imoralesgt/AR_CODEX/Control/ArquitecturaFirmware.jpeg

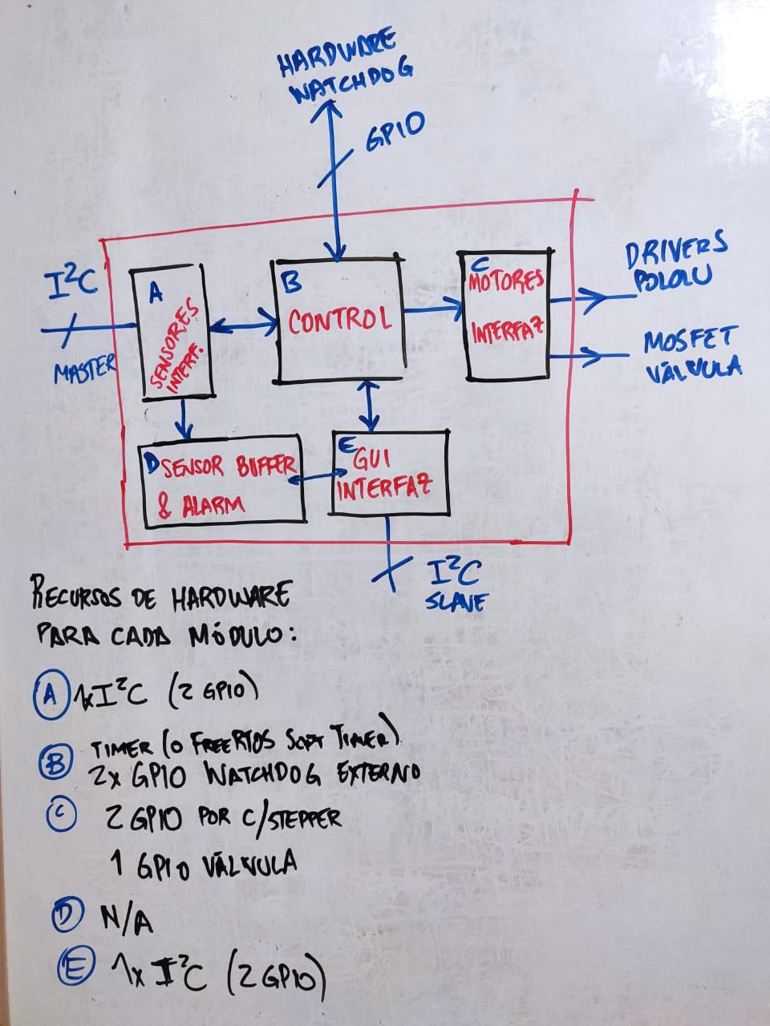
Control/ArquitecturaFirmware.jpeg
