imoralesgt/AR_CODEX/Sensors/Hardware/PCB sensores/Diseño V1/Sensores.png

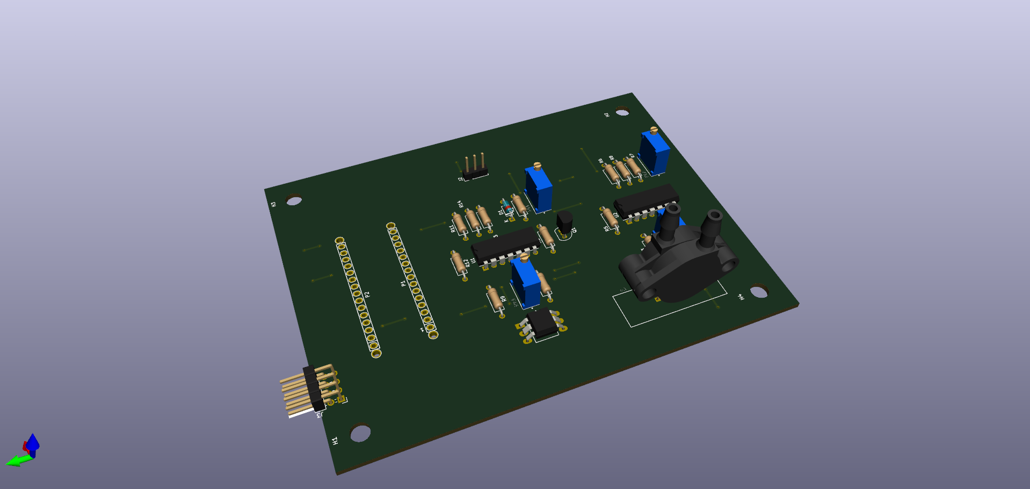
Sensors/Hardware/PCB sensores/Diseño V1/Sensores.png
