imoralesgt/AR_CODEX/Sensors/Hardware/CAD-3D-STL/RedPVC_Manguera.stl

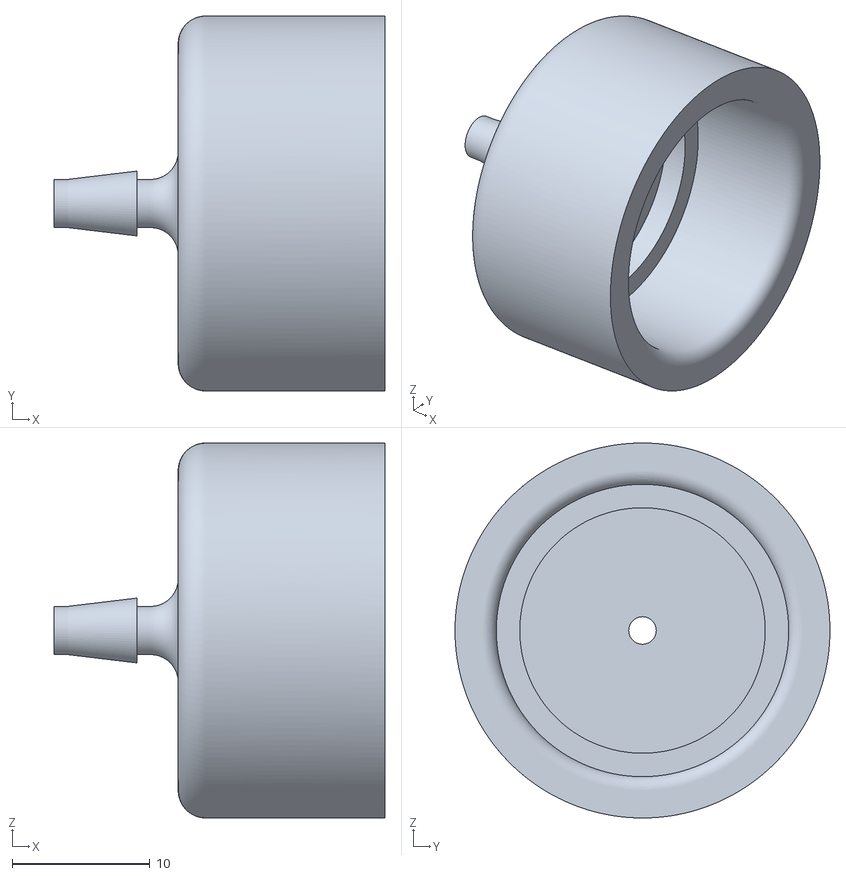
[picture p3: CAD file, 2020-06-14]
Sensors/Hardware/CAD-3D-STL/RedPVC_Manguera.stl
24.0 x 27.2 x 27.2
