imoralesgt/AR_CODEX/Sensors/Hardware/CAD-3D-STL/Sensor de Flujo/SMF3300_CONECTOR_LONG.stl

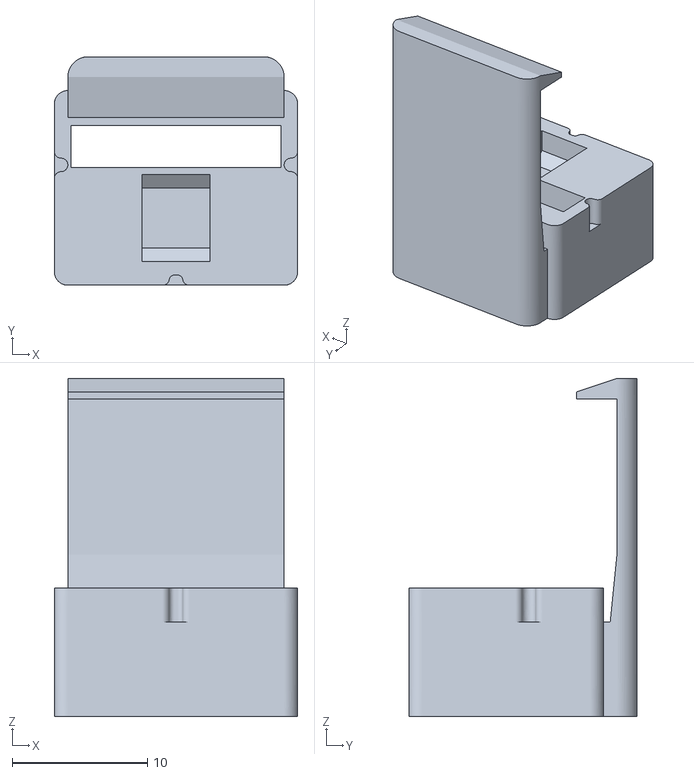
[picture p4: CAD file, 2020-09-03]
Sensors/Hardware/CAD-3D-STL/Sensor de Flujo/SMF3300_CONECTOR_LONG.stl
18.0 x 16.9 x 25.0
