imoralesgt/AR_CODEX/Sensors/Hardware/PCB sensores/MPX/MPX10DP--3DModel-STEP-56544.STEP

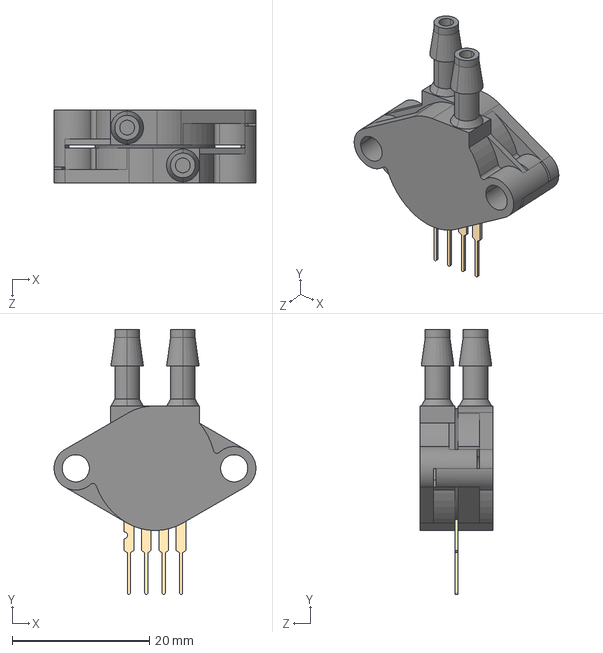
[picture p5: CAD file, 2020-06-14]
Sensors/Hardware/PCB sensores/MPX/MPX10DP--3DModel-STEP-56544.STEP
29.5 x 38.7 x 10.7 mm
