imoralesgt/AR_CODEX/Sensors/Hardware/PCB sensores/Pot/3296W-1-250--3DModel-STEP-56544.STEP

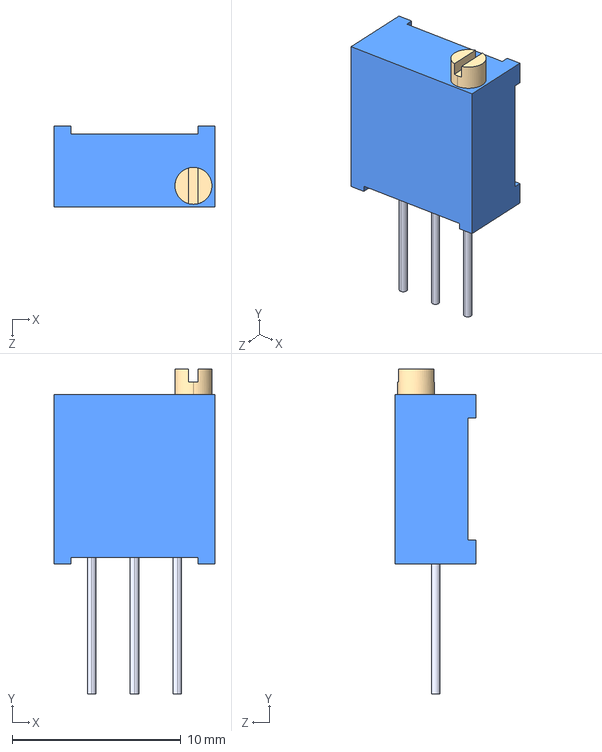
[picture p6: CAD file, 2020-06-14]
Sensors/Hardware/PCB sensores/Pot/3296W-1-250--3DModel-STEP-56544.STEP
9.53 x 19.3 x 4.83 mm
