imoralesgt/AR_CODEX/Sensors/Hardware/CAD-3D-STL/Codo_boquilla.stl

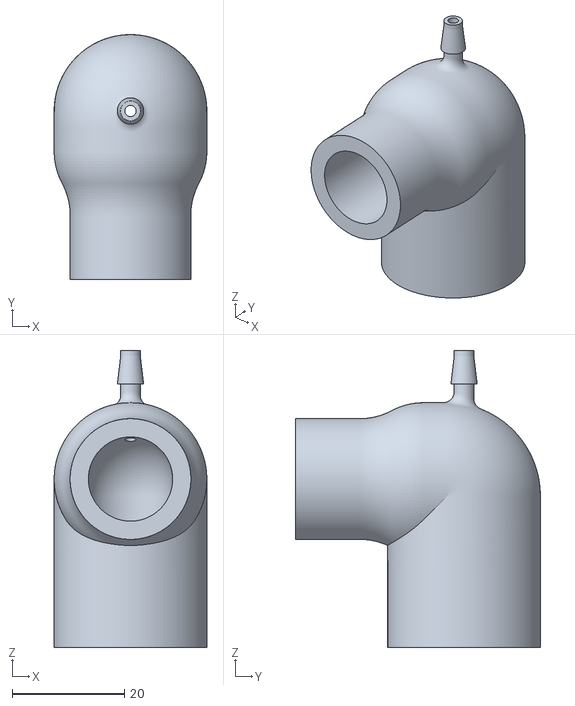
[picture p7: CAD file, 2020-06-14]
Sensors/Hardware/CAD-3D-STL/Codo_boquilla.stl
27.2 x 43.6 x 52.9
