imoralesgt/AR_CODEX/Sensors/Hardware/CAD-3D-STL/Sensor de Flujo/SMF3300_CONECTOR.stl

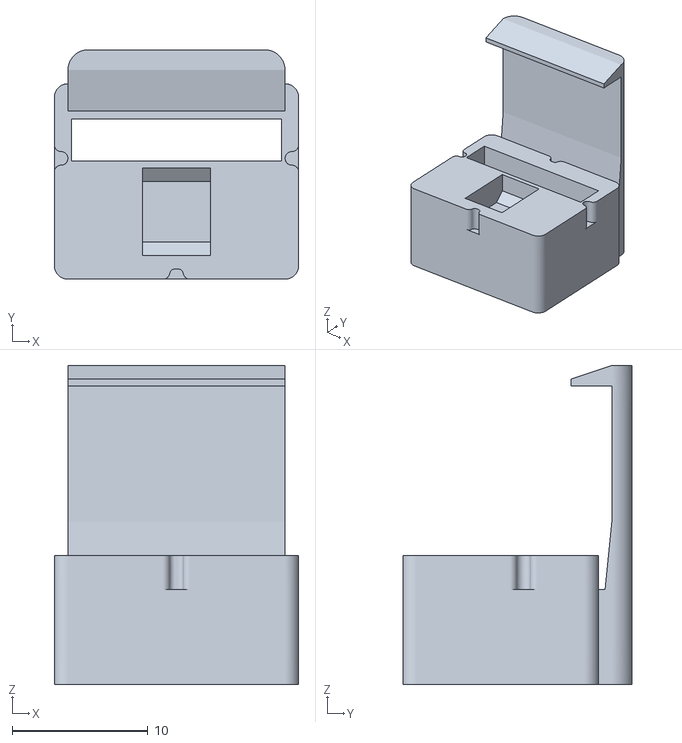
[picture p8: CAD file, 2020-09-03]
Sensors/Hardware/CAD-3D-STL/Sensor de Flujo/SMF3300_CONECTOR.stl
18.0 x 16.9 x 23.5
