imoralesgt/AR_CODEX/Sensors/Hardware/CAD-3D-STL/Sensor de Flujo/Conector.stl

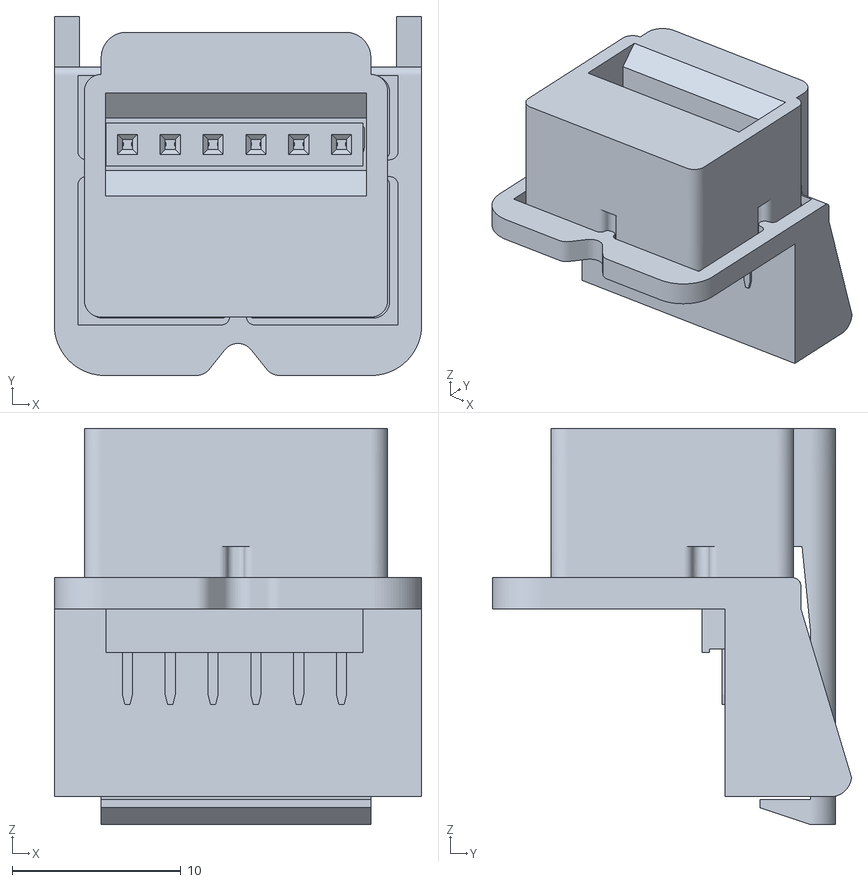
[picture p9: CAD file, 2020-09-03]
Sensors/Hardware/CAD-3D-STL/Sensor de Flujo/Conector.stl
21.8 x 21.3 x 23.5
