imoralesgt/AR_CODEX/Sensors/Hardware/CAD-3D-STL/VenturiV2.stl

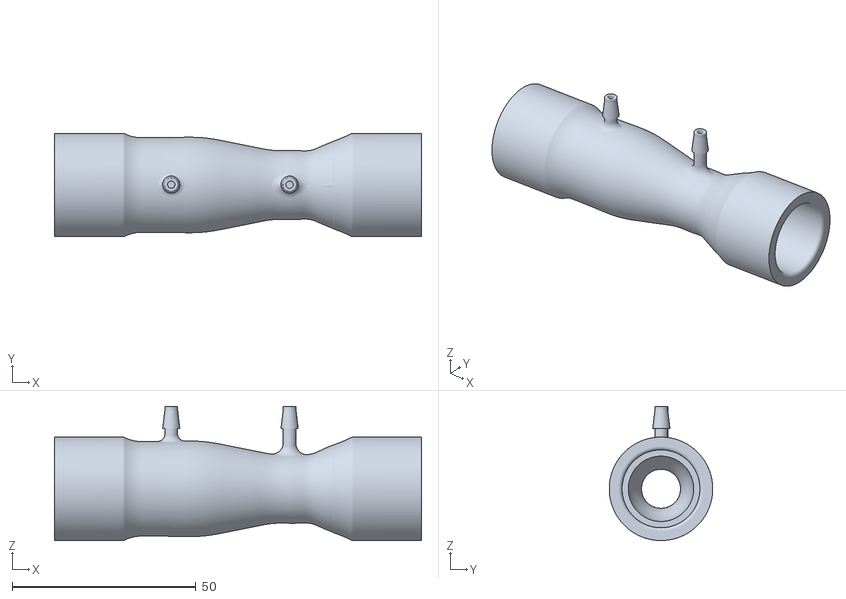
[picture p10: CAD file, 2020-06-14]
Sensors/Hardware/CAD-3D-STL/VenturiV2.stl
100.0 x 28.2 x 36.5
