imoralesgt/AR_CODEX/Sensors/Hardware/CAD-3D-STL/UnionAmbu_PVC.stl

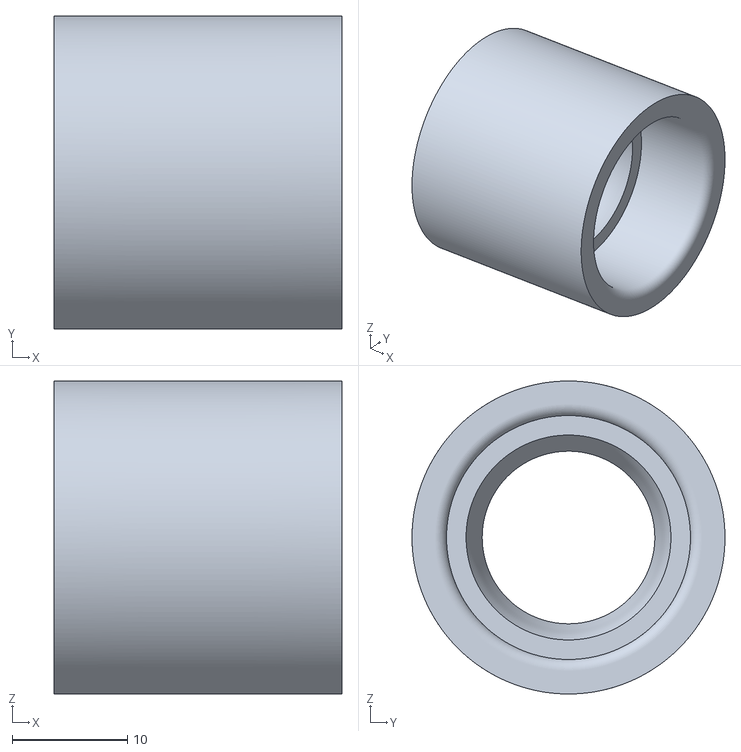
[picture p11: CAD file, 2020-06-14]
Sensors/Hardware/CAD-3D-STL/UnionAmbu_PVC.stl
25.0 x 27.2 x 27.2
