imoralesgt/AR_CODEX/(list of files, cad)

Other CAD files:
3DModels/EndSwitch.ipt
3DModels/OldVersions/EndSwitch.0001.ipt
3DModels/OldVersions/StartAssembly.0002.iam
3DModels/OldVersions/StartSupport.0009.ipt
3DModels/StartAssembly.iam
3DModels/StartSupport.ipt
Sensors/Hardware/CAD-3D-STL/Sensor de Flujo/Conector.iam
Sensors/Hardware/CAD-3D-STL/Sensor de Flujo/OldVersions/Conector.0004.iam
Sensors/Hardware/CAD-3D-STL/Sensor de Flujo/OldVersions/PCB_SMF3300.0005.ipt
Sensors/Hardware/CAD-3D-STL/Sensor de Flujo/OldVersions/SMF3300_CONECTOR.0009.ipt
Sensors/Hardware/CAD-3D-STL/Sensor de Flujo/OldVersions/TUBE_PCB.0008.ipt
Sensors/Hardware/CAD-3D-STL/Sensor de Flujo/PCB_SMF3300.ipt
Sensors/Hardware/CAD-3D-STL/Sensor de Flujo/SMF3300_CONECTOR.ipt
Sensors/Hardware/CAD-3D-STL/Sensor de Flujo/TUBE_PCB.ipt
