imoralesgt/AR_CODEX/PCBControl/PCB-fuente_2step_ATmegaVF3v3/PCB-fuenteback.jpg

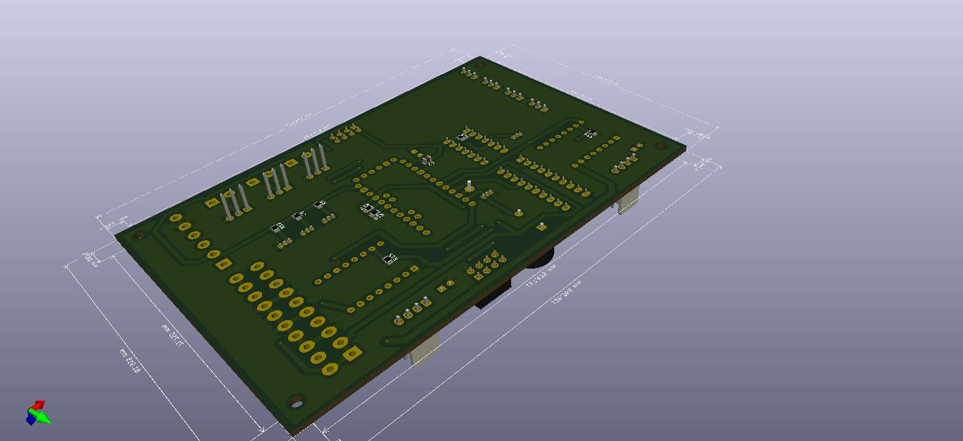
PCBControl/PCB-fuente_2step_ATmegaVF3v3/PCB-fuenteback.jpg
