imoralesgt/AR_CODEX/Sensors/Firmware/Testing/SENSORS/ADP1101/Graficas y Muestras/Lecturas(24cmH2O).png

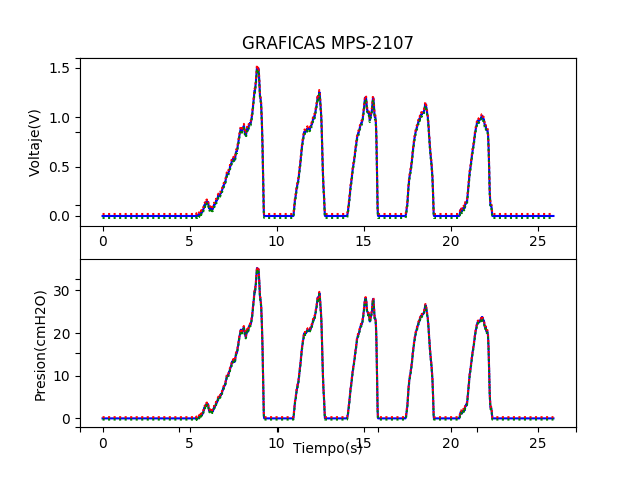
Sensors/Firmware/Testing/SENSORS/ADP1101/Graficas y Muestras/Lecturas(24cmH2O).png
