imoralesgt/AR_CODEX/Sensors/Firmware/Testing/SENSORS/ADP1101/Graficas y Muestras/Lecturas(34cmH2O).png

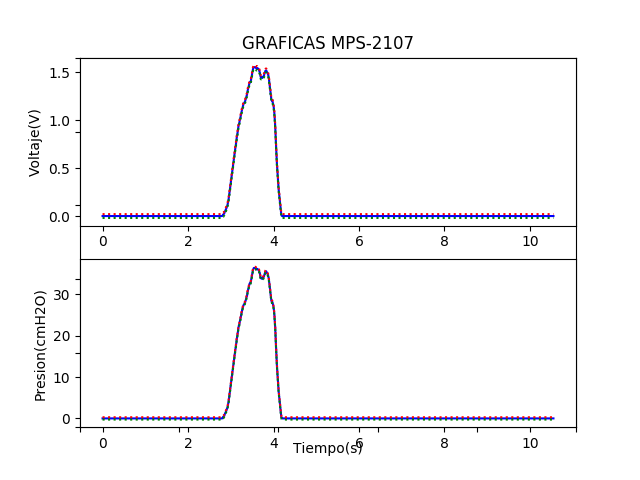
Sensors/Firmware/Testing/SENSORS/ADP1101/Graficas y Muestras/Lecturas(34cmH2O).png
