imoralesgt/AR_CODEX/PCBControl/PCB-fuente_2step_ATmegaVF3v3/esquema.pdf

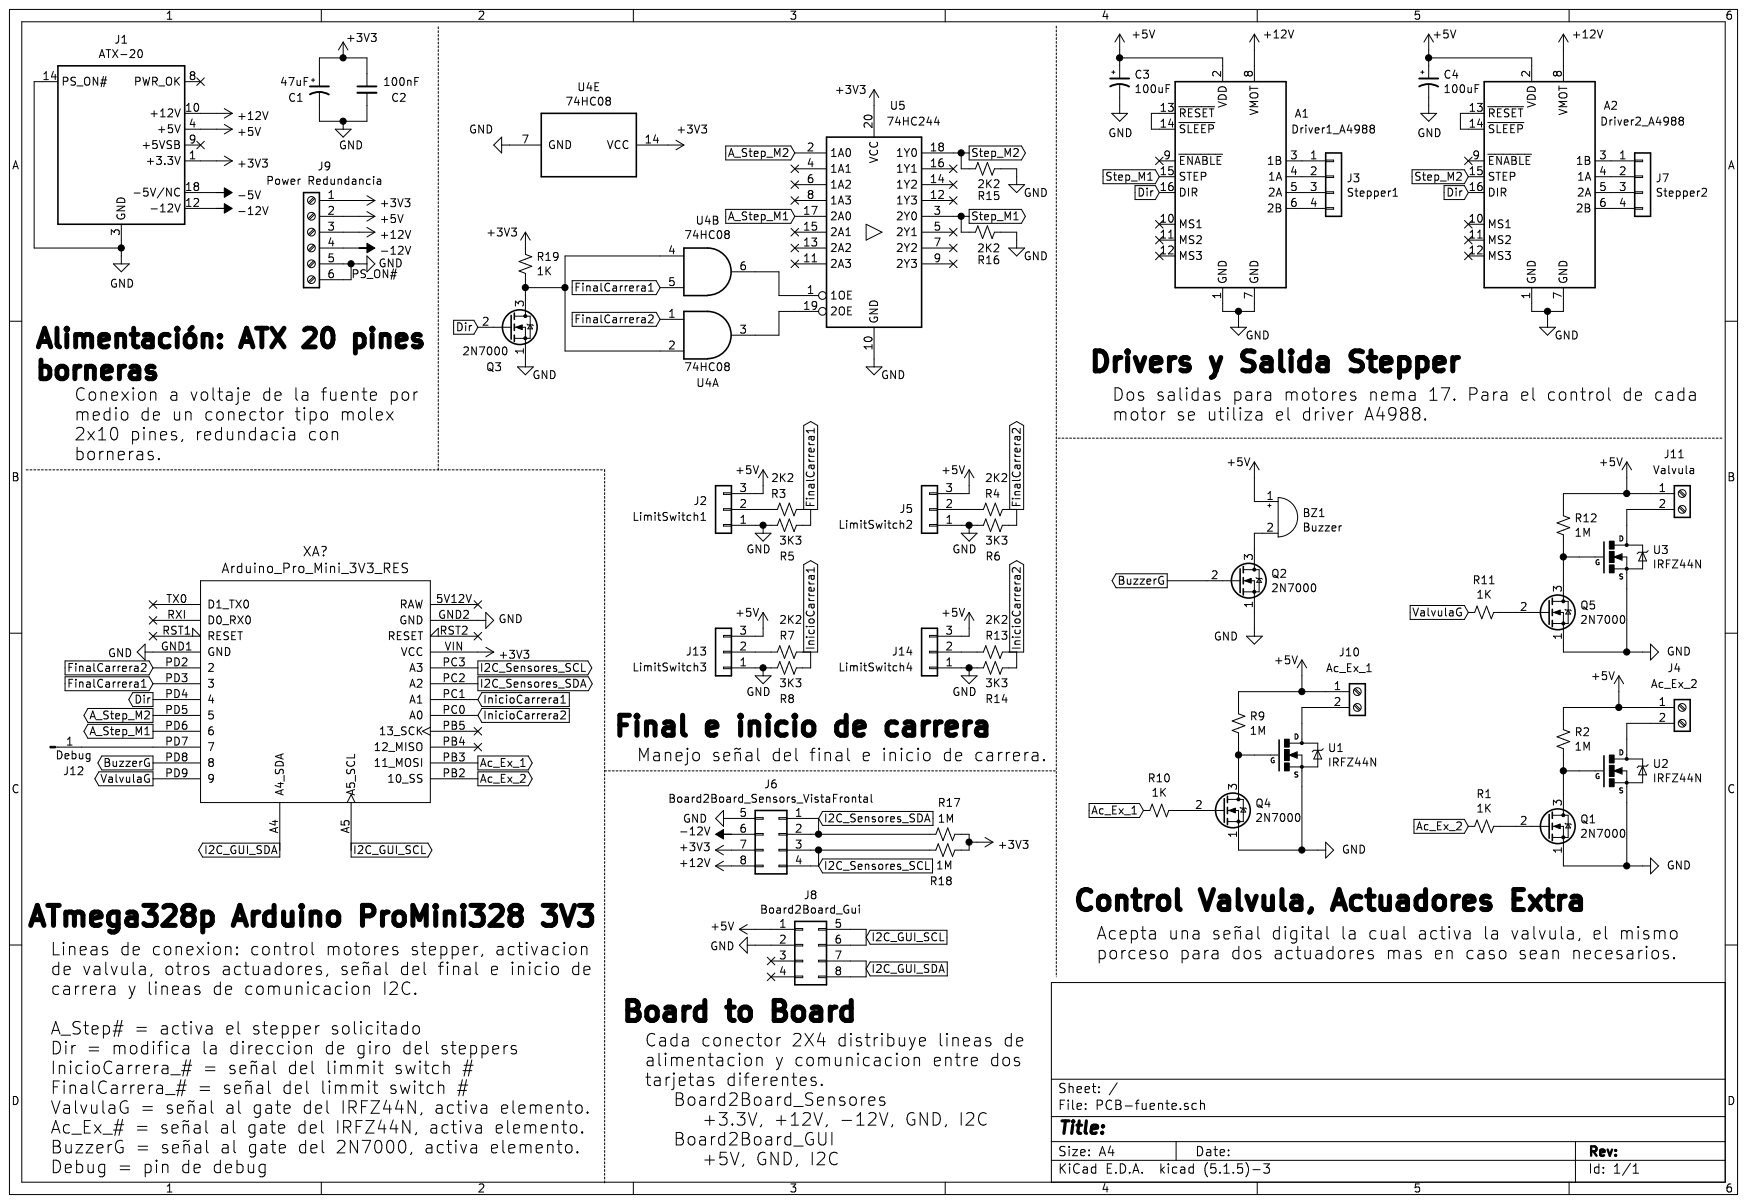
[picture p25: page 1]
