imoralesgt/AR_CODEX/PCBControl/PCB-fuente_2step_ATmegaVF3v3/placa.pdf

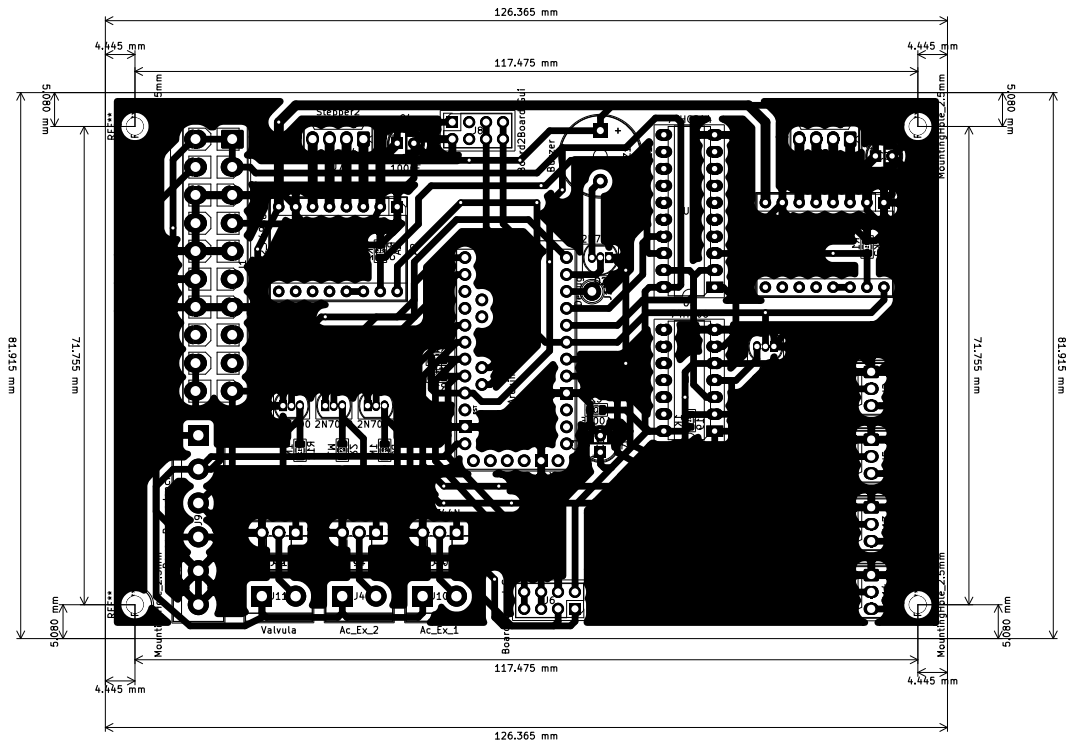
[picture p26: page 1]
