imoralesgt/AR_CODEX/PCBControl/PCB-fuente_2step_ATmegaVF3v3/placa1.pdf

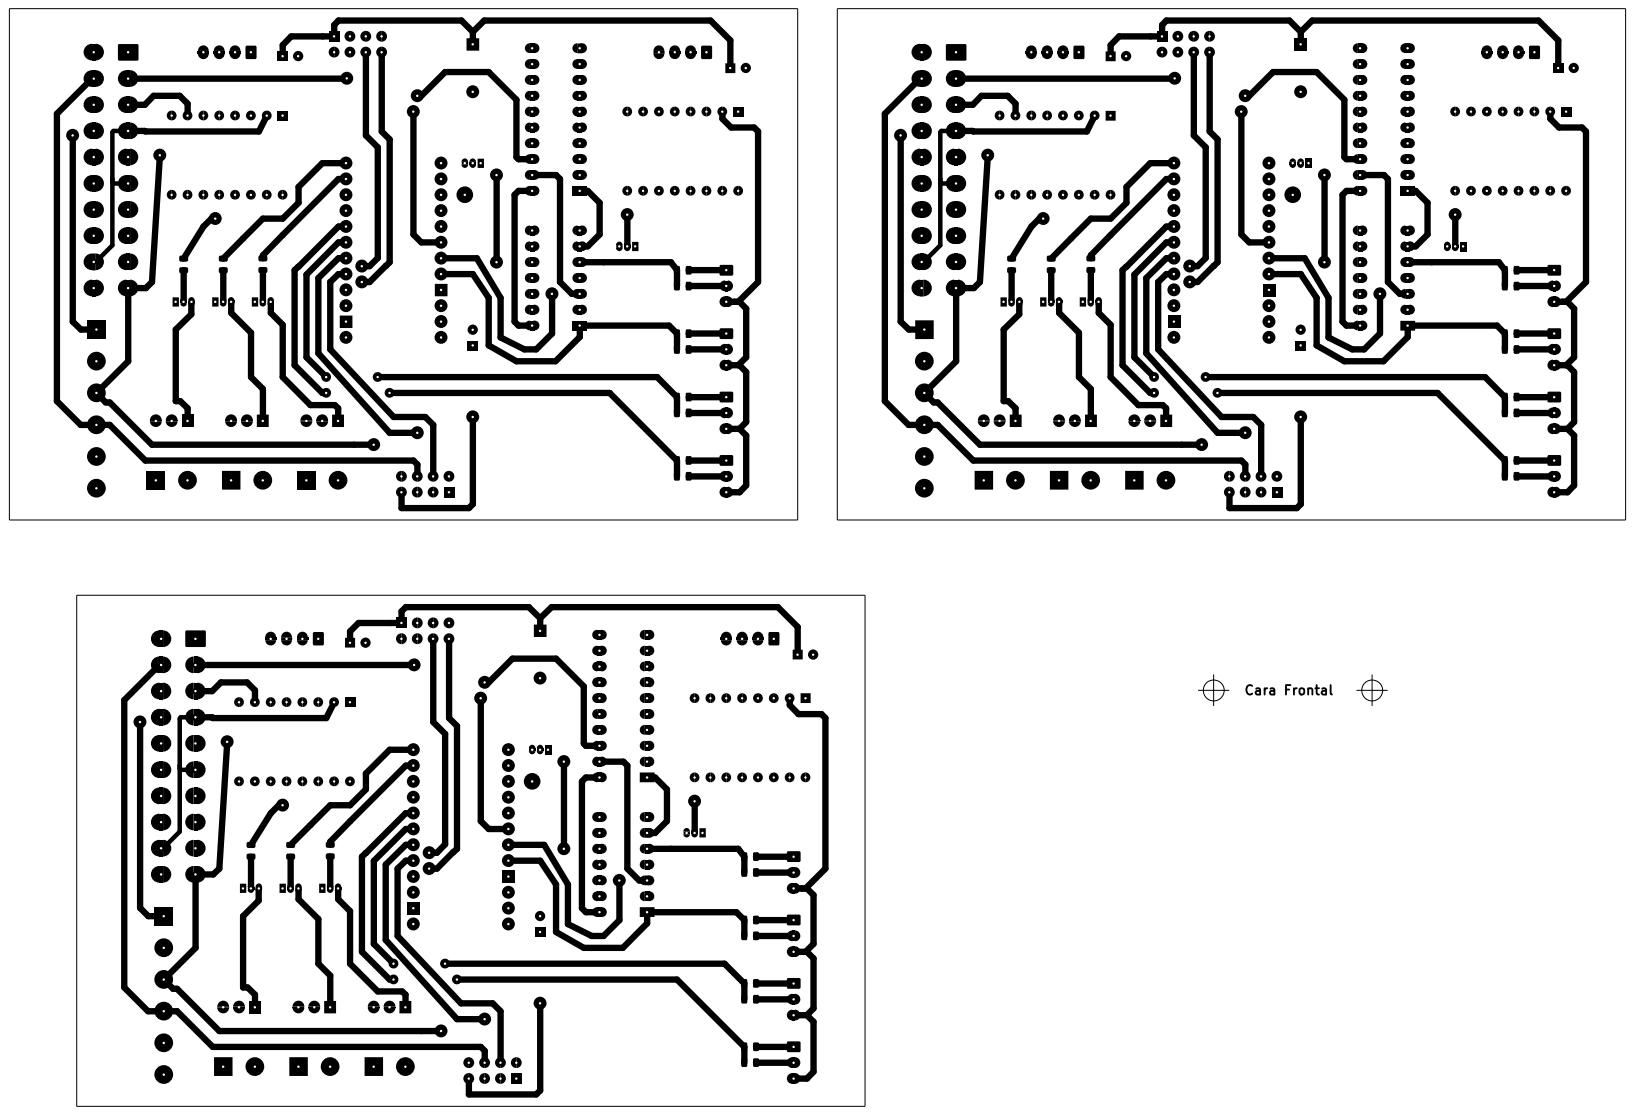
[picture p27: page 1]

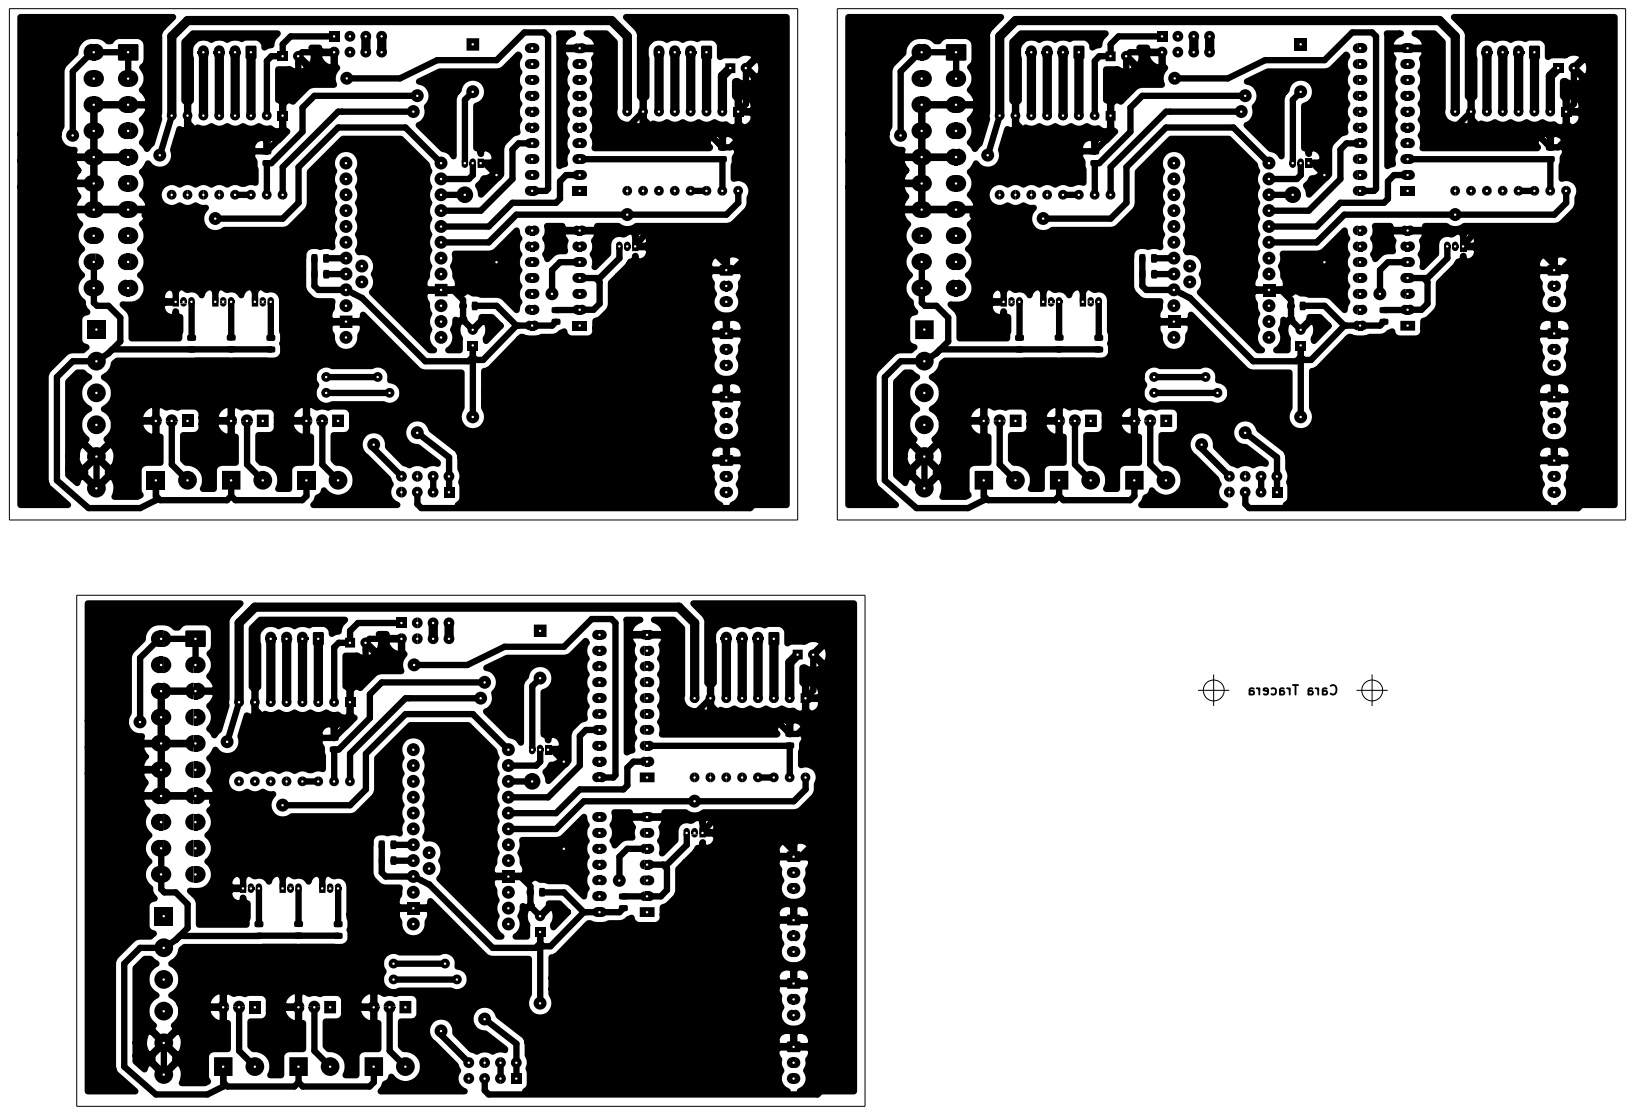
[picture p28: page 2]

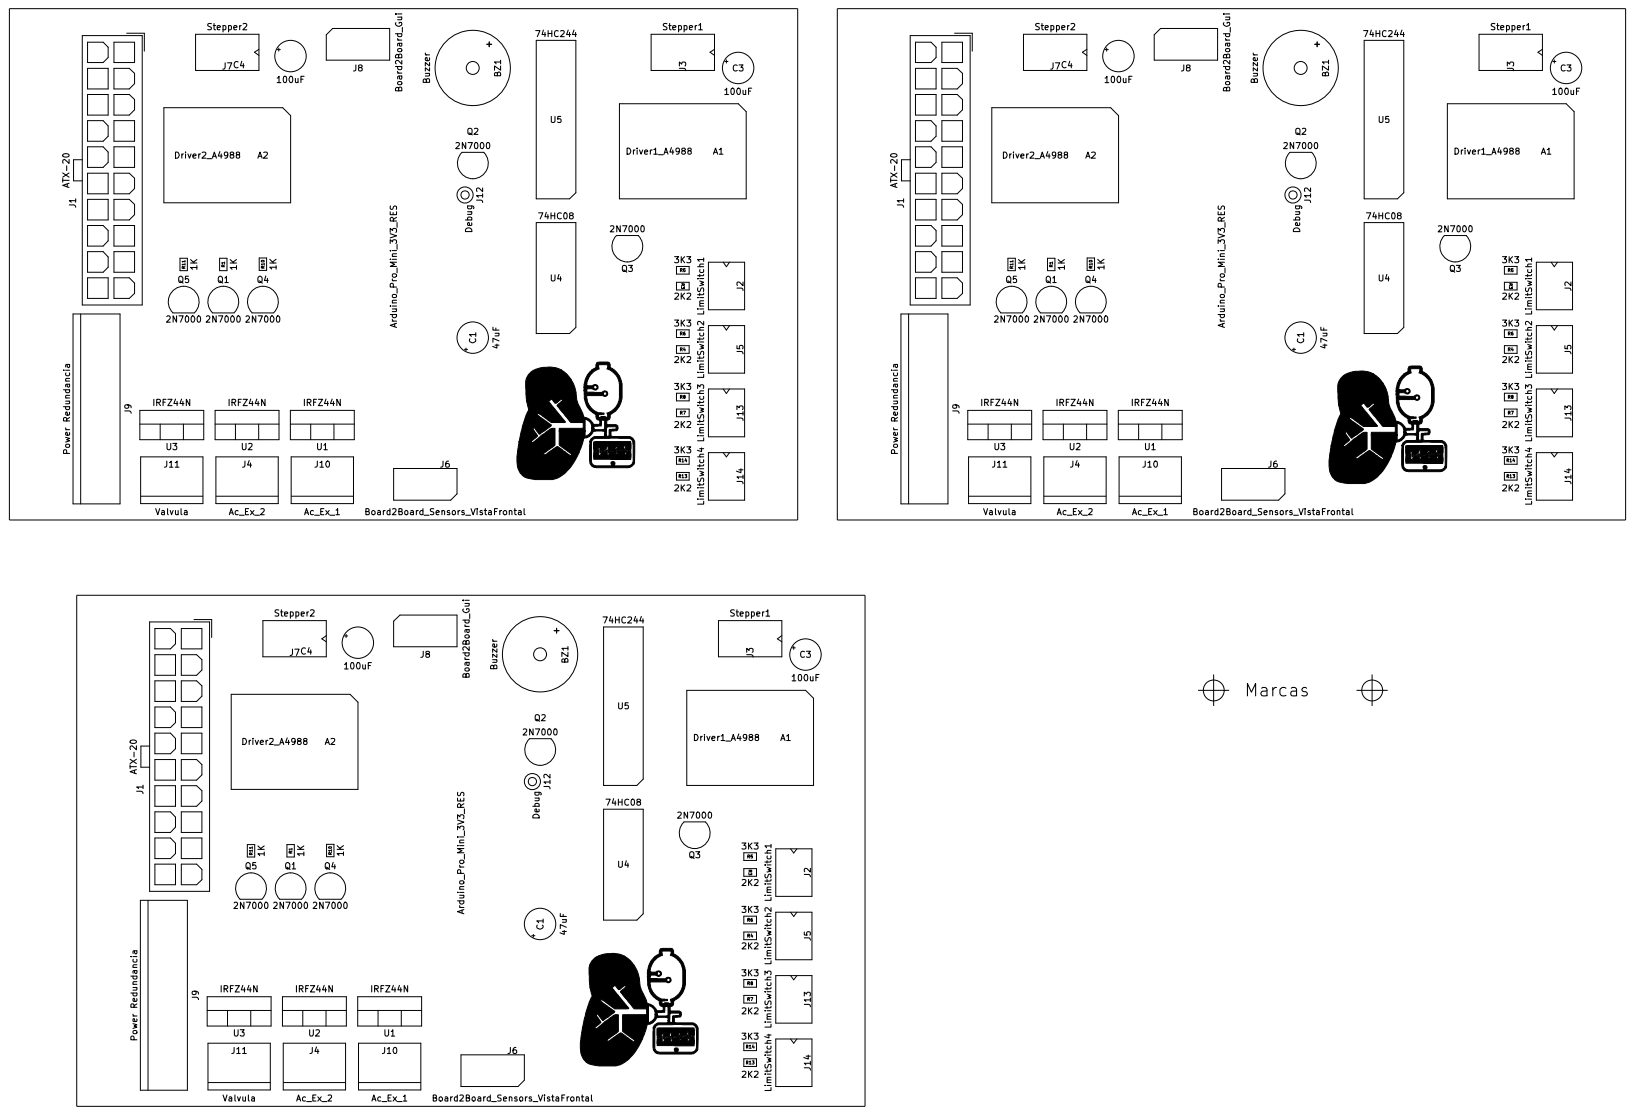
[picture p29: page 3]
