imoralesgt/AR_CODEX/PCBControl/PCB-fuente_2step_ATmegaVF3v3/placa1invert.pdf

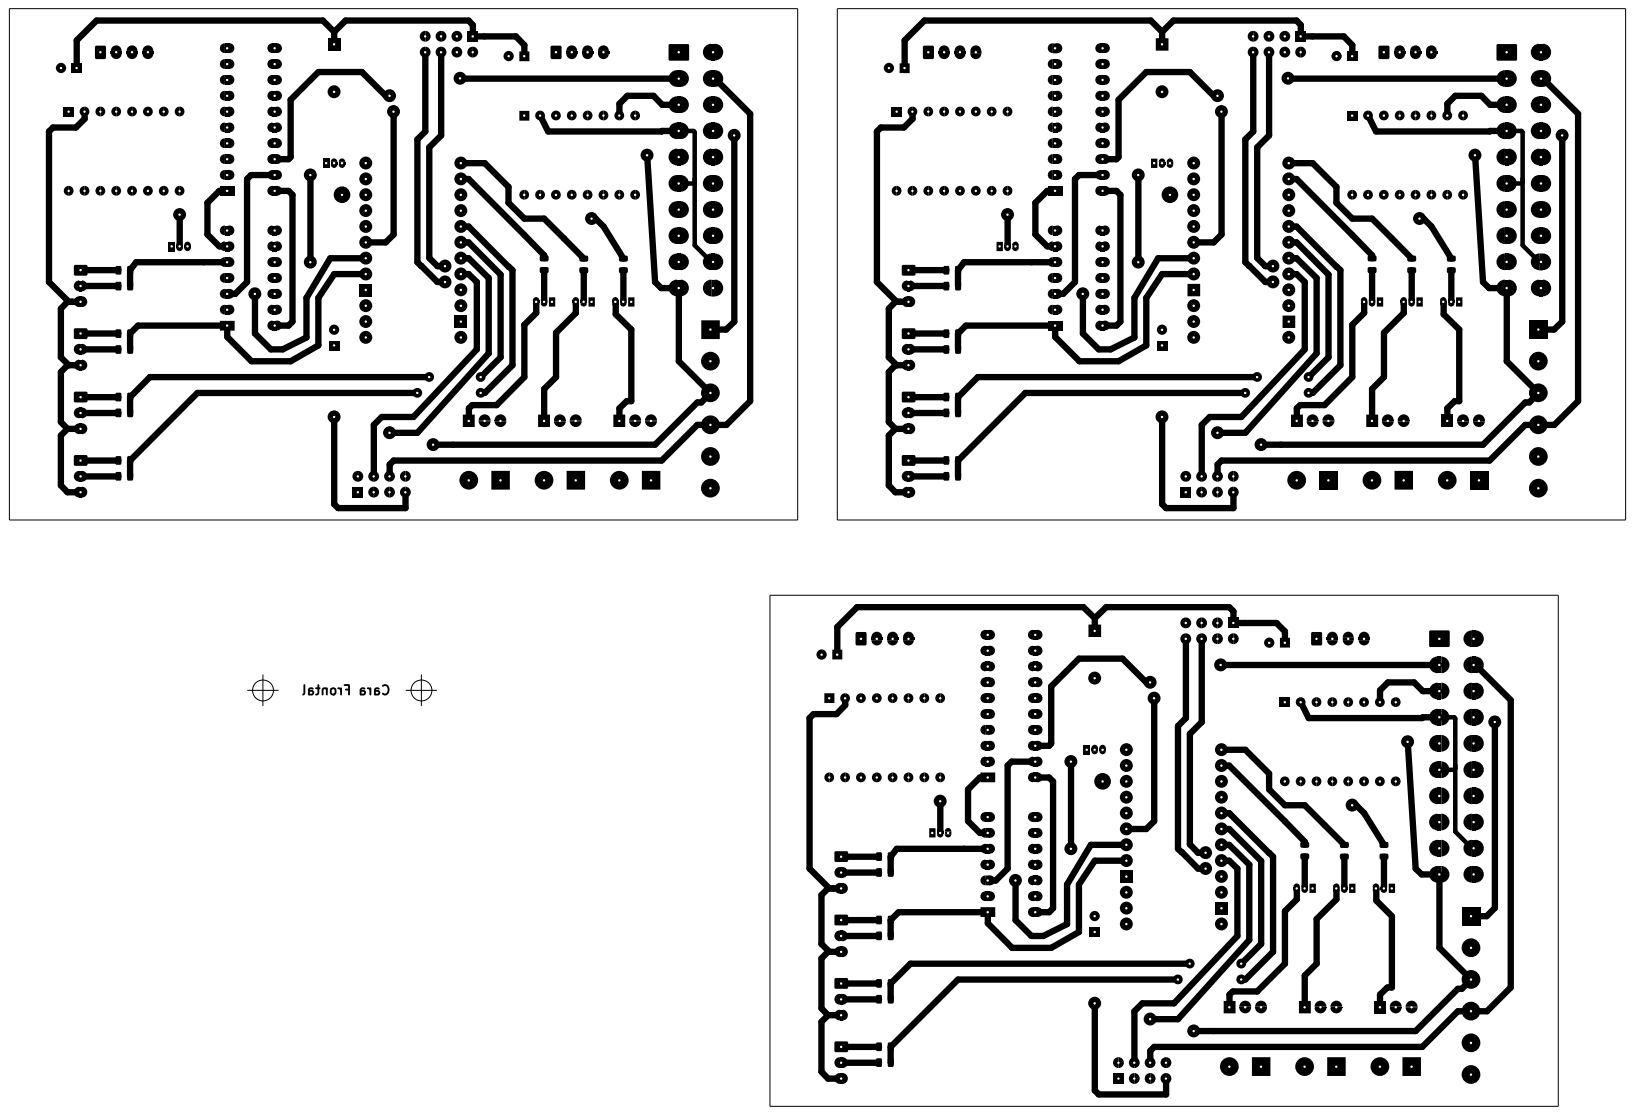
[picture p30: page 1]

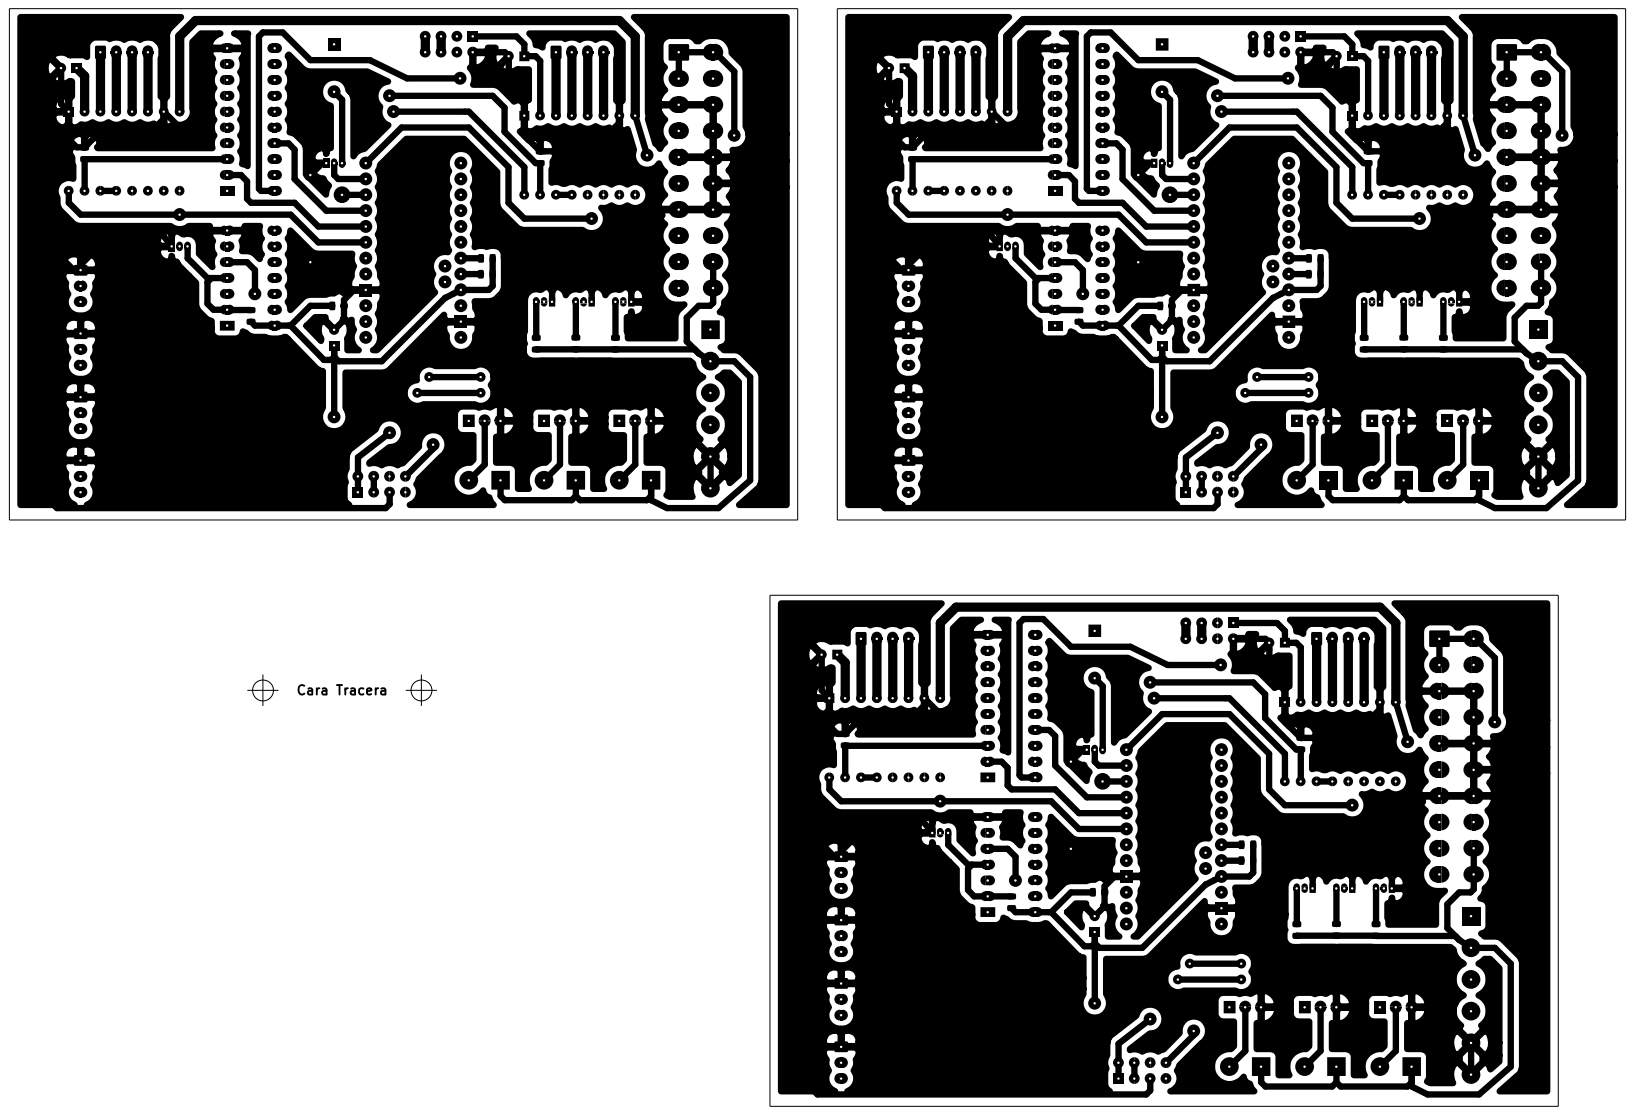
[picture p31: page 2]

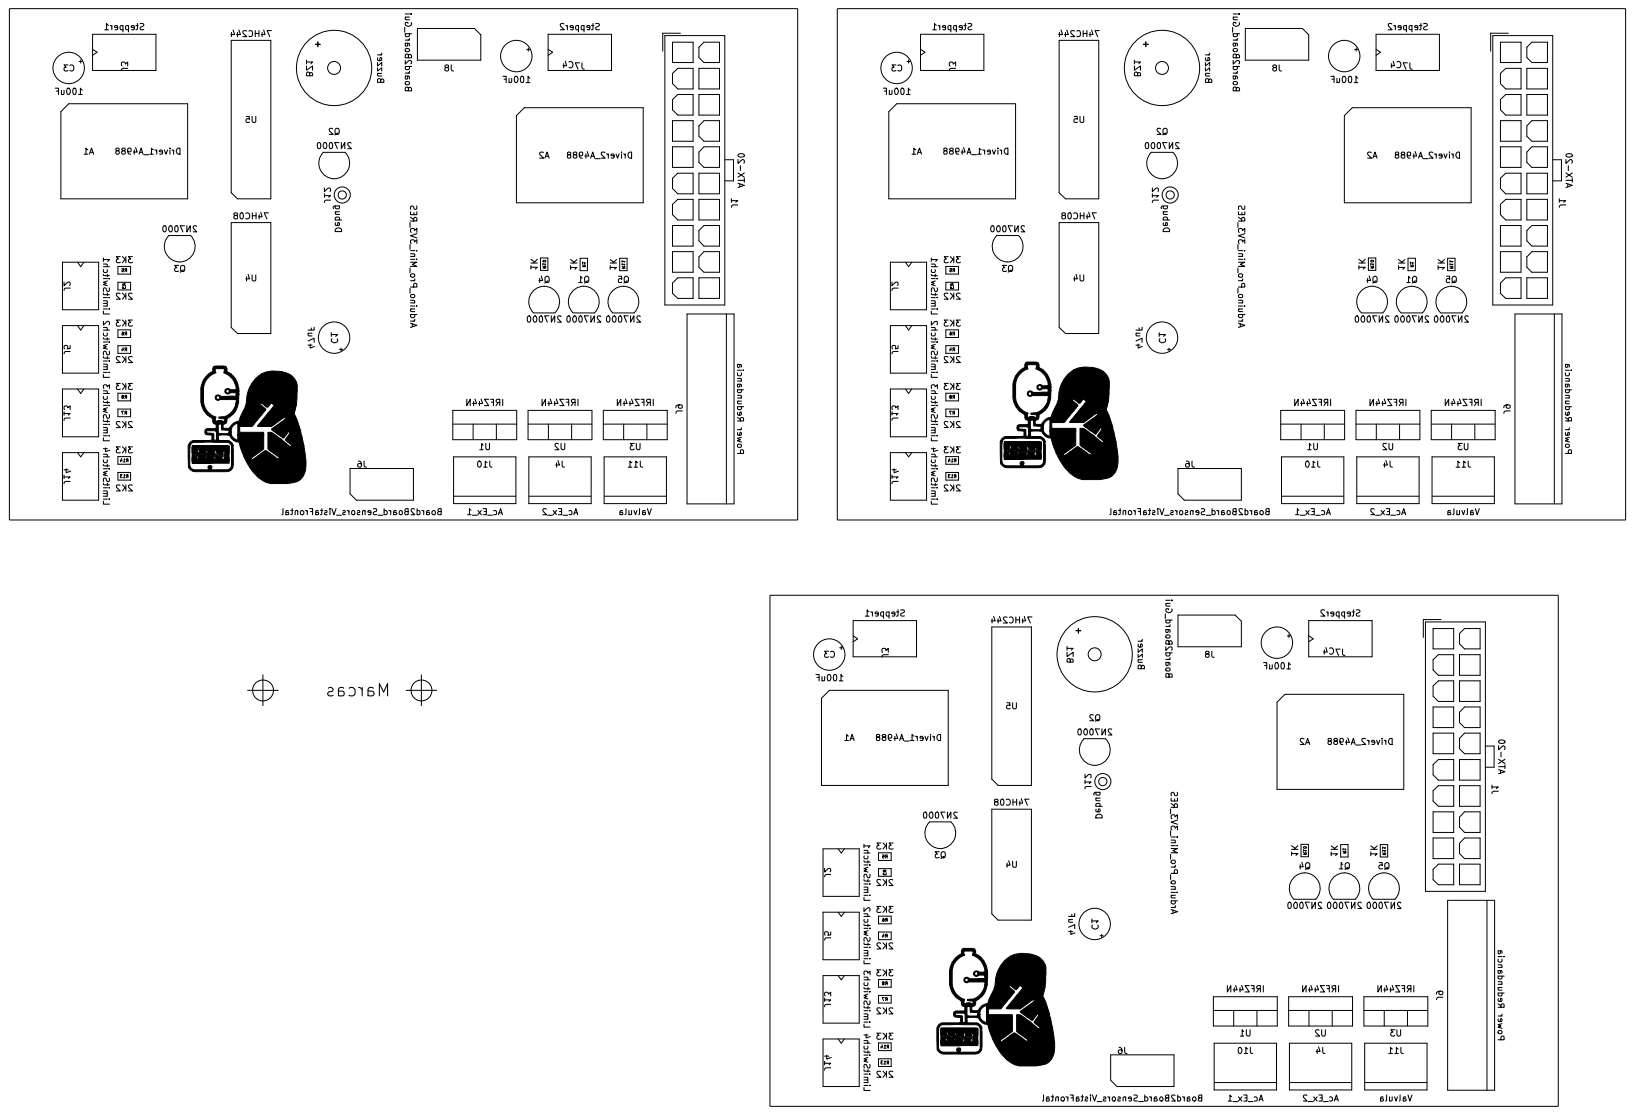
[picture p32: page 3]
