imoralesgt/AR_CODEX/Sensors/Hardware/PCB sensores/Diseño V1/Sensores_V1.kicad_pcb

## KiCad design Sensors/Hardware/PCB sensores/Diseño V1/Sensores_V1.kicad_pcb (2020-06-14)

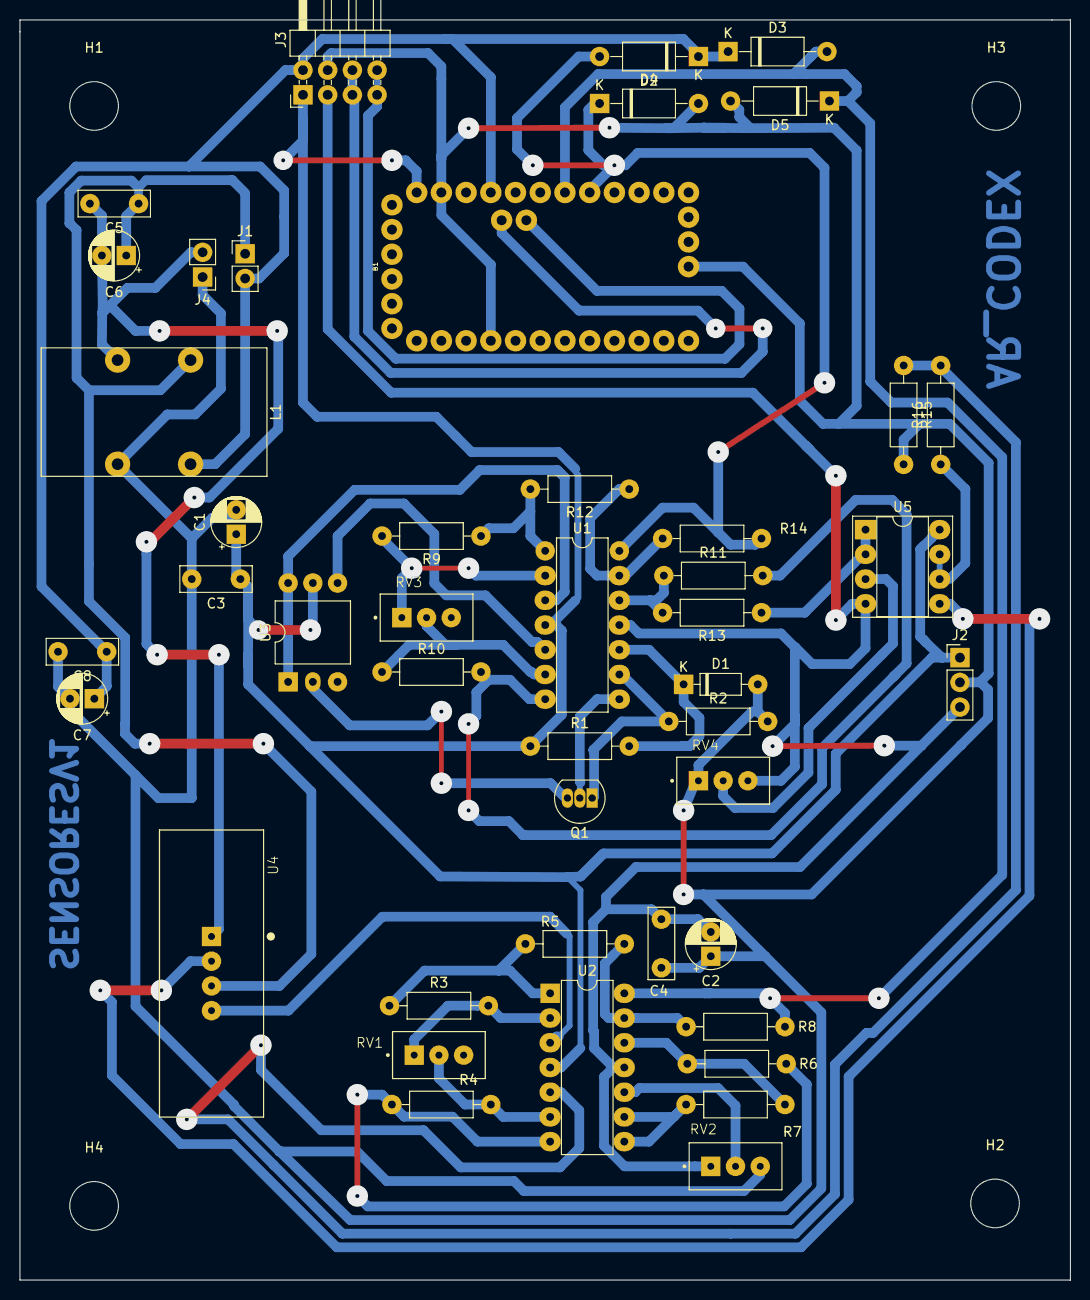
[picture p34: board Sensores_V1.kicad_pcb from above]

Board: 2 copper layers, 108.0 x 129.5 mm, 49 parts (0 on the bottom side), 36 nets.

Parts:
B1: ARDUINO_PRO_MINI
C1, C2, C6, C7: CP; CP_Radial_D5.0mm_P2.50mm
C3, C4, C5, C8: C; C_Rect_L7.2mm_W2.5mm_P5.00mm_FKS2_FKP2_MKS2_MKP2
D1: D_Zener_2.2V; D_DO-35_SOD27_P7.62mm_Horizontal
D2, D3, D4, D5: DIODE; D_A-405_P10.16mm_Horizontal
H1, H2, H3, H4: MountingHole; MountingHole_5mm
J1, J4: Conn_01x02_Female; PinHeader_1x02_P2.54mm_Vertical
J2: Conn_01x03; PinHeader_1x03_P2.54mm_Vertical
J3: Conn_02x04_Top_Bottom; PinHeader_2x04_P2.54mm_Horizontal
L1: L_Core_Ferrite_Coupled; L_CommonMode_Wuerth_WE-CMB-M
Q1: 2N3904; TO-92_Inline
R1: 2k2; R_Axial_DIN0207_L6.3mm_D2.5mm_P10.16mm_Horizontal
R2: 1k5; R_Axial_DIN0207_L6.3mm_D2.5mm_P10.16mm_Horizontal
R3, R4: 100k; R_Axial_DIN0207_L6.3mm_D2.5mm_P10.16mm_Horizontal
R5, R6, R7, R8, R9, R10, R11, R12, R13, R14: 10k; R_Axial_DIN0207_L6.3mm_D2.5mm_P10.16mm_Horizontal
R15: 1M; R_Axial_DIN0207_L6.3mm_D2.5mm_P10.16mm_Horizontal
R16: 5k1; R_Axial_DIN0207_L6.3mm_D2.5mm_P10.16mm_Horizontal
RV1, RV3: 5k; TRIM_3296W-1-254LF
RV2, RV4: 100k; TRIM_3296W-1-254LF
U1, U2: LM324; DIP-14_W7.62mm
U3: ADP1101; DIP-6_W10.16mm
U4: MPX10DP; SIP1067W46P254L2946H2934Q4P
U5: LM358; DIP-8_W7.62mm_Socket

Connections:
+3.3VA: C5.1, C6.1, J1.1, L1.1, U4.3
+3V3: B1.21, C7.1, C8.1, D2.2, D3.2, J1.2, J3.2, L1.2
+12V: B1.24, C1.1, C3.1, J2.1, J3.1, R1.1, U1.4, U2.4, U3.2, U5.8
+OutputADP1101: U1.5, U3.3
+OutputMPX10DP: U4.2, U5.5
-12V: C2.2, C4.2, J2.3, J3.3, RV2.1, RV4.3, U1.11, U2.11, U5.4
-OutputADP1101: U1.3, U3.1, U3.6
-OutputMPX10DP: U2.3, U4.4
/A0:ADP1101: B1.17, D2.1, D4.2, R14.1, U1.14
/A1:MPX10DP: B1.18, D3.1, D5.2, R8.1, U2.14
/I2C:SCL: B1.A5, J3.5, J3.6
/I2C:SDA: B1.A4, J3.7, J3.8
GND: B1.4, B1.23, C1.2, C2.1, C3.2, C4.1, C7.2, C8.2, D1.2, D4.1, D5.1, J2.2, J3.4, J4.1, L1.4, R2.2, R15.2, RV2.3, RV4.1
GNDA: C5.2, C6.2, J4.2, L1.3, U4.1
unnamed: D1.1, R1.2, U1.10
unnamed: Q1.1, R2.1, U1.9
unnamed: Q1.2, U1.8
unnamed: Q1.3, U3.5
unnamed: R3.1, R5.2, U2.1
unnamed: R3.2, RV1.1, U2.2
unnamed: R4.1, RV1.2, U2.6
unnamed: R4.2, R6.2, U2.7
unnamed: R5.1, R8.2, U2.13
unnamed: R6.1, R7.1, U2.12
unnamed: R7.2, U2.8, U2.9
unnamed: R9.2, RV3.1, U1.2
unnamed: R10.1, RV3.2, U1.6
unnamed: R10.2, R11.2, U1.7
unnamed: R11.1, R13.2, U1.12
unnamed: R12.1, R14.2, U1.13
unnamed: R9.1, R12.2, U1.1
unnamed: R13.1, U5.1, U5.2
unnamed: R15.1, R16.2, U2.5
unnamed: R16.1, U5.6, U5.7
unnamed: RV2.2, U2.10
unnamed: RV4.2, U5.3
