imoralesgt/AR_CODEX/Control/arcontrol.cpp

#include "arcontrol.h"
#include "pinout.h"
#include "globals.h"
#include "Pid.h"
#include "pinout.h"
#include "argpio.h"



/*
==========================================================================================================
- Inspiration and expiration slope computation methods done
- Initialization (at constructor) of PID & Motor variables done
- Preliminar version of control strategy done (controlFlow method)

ToDo:
    - Create interconnection methods for external modules
    - Instantiate modules into top module (Control.ino)
    - Interconnect modules into top module (Control.ino)
    - Test control system
==========================================================================================================
*/






//PID Instantiation
Pid pp(KP, KI, KD, MOTOR_MIN_OUT, MOTOR_MAX_OUT);

//GPIO Instantiation
argpio gp;

/*
======================
Constructor/Destructor
======================
*/

arcontrol::arcontrol(){
    this -> __resetInitParametersFlag(); //IRM initialization from GUI not done yet.
    this -> controlSetPoint = 0.0; //IRM Airflow set-point value
}

//IRM Destructor: do nothing
arcontrol::~arcontrol(){
    ;
}




/*
==============
Public methods
==============
*/

//IRM Gets init parameters from GUI I2C controller block, which are set as working set-points.
//Returns 0 if everything ok. Call this method from an external module function
int arcontrol::setInitParameters(float pressure, float minVol, float maxVol, float rpm, float ieRatio){
    this -> __setSpPressure(pressure);
    this -> __setSpRPM(rpm);
    this -> __setSpIeRatio(ieRatio);

    this -> __setSpMinVol(minVol);
    this -> __setSpMaxVol(maxVol);

    this -> __setInitParametersFlag(); //Initial parameters already received!


    //Setup initial motor & PID conditions
    this -> currentCycleSlope = __computeISlope(this->getSpRPM(), this->getSpIeRatio(), this->getSpMinVol(), this->getSpMaxVol());
    this->setCurrentCycleVolume(0); //No air hasn't been pushed yet
    this -> updateSetPoint(this->currentCycleSlope);
    this->currentDirection = INSP;
    pp.resetIDvalues(); 

    this -> inspirationClkCycles = 0;

    
    return 0;
}

void arcontrol::updateControlParameters(float pressure, float minVol, float maxVol, float rpm, float ieRatio){
    this -> __setSpPressure(pressure);
    this -> __setSpRPM(rpm);
    this -> __setSpIeRatio(ieRatio);

    this -> __setSpMinVol(minVol);
    this -> __setSpMaxVol(maxVol);
    pp.resetIDvalues();
}

void arcontrol::updateSetPoint(float sp){
    pp.pidSetPoint(sp);
}

int arcontrol::towardsHome(int motorIndex){
    if(gp.dRead(START_ENDSTOP[motorIndex])){ //if home endstop has been activated
        this -> setMotorSpeed(motorIndex, 0); //Stop motor motion
        //Serial.println("HME");
        return 1; //We have reached home right now!
    }else{
        this -> setMotorSpeed(motorIndex, MOTOR_MIN_OUT);  //Move motor backwards
        //Serial.println("TWDS");
        return 0; //We haven't reached home in the specified motor yet
    }
}


void arcontrol::goHome(void){
    int i;
    int ok = 0;
    this -> motorsHoming = 1;
    while(ok < TOTAL_MOTORS){
        ok = 0;
        for(i = 0; i < TOTAL_MOTORS; i++){
            ok += towardsHome(i);
        }
    }
    this -> motorsHoming = 0;
    this -> motorsHomed = 1;
}


/*
    Estrategia de control:

    Ciclo inicial:
    - Asegurarse que ambú esté presionado 0%
    - Mover motor (lentamente) hasta alcanzar volumen mínimo deseado (tomando como base medidas de flujo/caudal (R))
        ~ Volumen = Caudal * Tiempo
    - Iniciar proceso cíclico contorlado por PID, supervisando no exceder el límite de presión en ningún instante

    Proceso cíclico:
    Calcular el caudal necesario para lograr enviar al paciente el volumen requerido a la tasa de respiraciones
    por minuto, cumpliendo también con la tasa de inspiración y expiración.

    La variable a controlar es el flujo. Las pendientes (Delta V / Delta t) se calculan en base a los siguientes requisitos:
        - Respiraciones por minuto
        - Relación I:E
        - Delta Volumen (Volumen Mínimo Ambu, Volumen Máximo Ambú)

*/


float arcontrol::controlFlow(float currentFlow, float currentPressure){
    volatile float newOutput; //Current output
    static float accumulatedCycleVolume;
    static long accumulatedOverPressureCycles;
    float expirationPeriod;
    static long maxExpirationCycles;
    static long maxInspirationCycles = 0;
    
    static int homedMotors;
    int i;

    if(this->currentDirection == INSP){ //If pushing air into patient's lungs

       
        //Compute current cycle accumulated volume
        accumulatedCycleVolume = this->computeCurrentCycleVolume(currentFlow);
        this -> setCurrentCycleVolume(accumulatedCycleVolume);

        //If inspiration is taking longer than expected, maybe due to a motor stuck in the emergency endstop switch, go back to expiration mode
        this -> inspirationClkCycles += 1;
        #ifdef DEBUG_MODE
            Serial.println(this -> inspirationClkCycles);
        #endif
        if(this -> inspirationClkCycles > maxInspirationCycles){
            this -> inspirationClkCycles = 0;
            accumulatedCycleVolume = this -> getSpMaxVol() + 1;
            setCurrentCycleVolume(accumulatedCycleVolume); //Forcing state change to expiration mode
        }



        //If an overpressure condition is detected
        if(currentPressure > this->getSpPressure()){ //If max. expected pressure is detected
            if(++accumulatedOverPressureCycles < MAX_OVERPRESSURE_CYCLES){
                this->__reduceMaxPIDOut(pp.getMaxOut()); //Gradually reduce motor output speed (inspiration only)
            }else{
                accumulatedOverPressureCycles = 0;
                this -> setCurrentCycleVolume(this->getSpMaxVol() + 1);
            }
        }

        // Serial.print("Vol: "); Serial.println(accumulatedCycleVolume); //Serial.print("Max: "); Serial.println(this -> getSpMaxVol());

        //If maxvol hasn't been reached yet, keep pushing ambu
        if(accumulatedCycleVolume < this->getSpMaxVol()){
            
            newOutput = pp.pidUpdate(currentFlow);

        }else{
            Serial.print("IN ");
            Serial.println(this -> getCurrentCycleVolume());

            Serial.print("MAX ");
            Serial.println(this -> getSpMaxVol());

            //Otherwise, stop motor and change currentDirection to EXPIRATION
            this->setCurrentCycleVolume(this->getSpMaxVol()); //Now start decreasing volume next clock cycle
            expirationPeriod = this -> __computeEDuration(this -> getSpRPM(), this -> getSpIeRatio()); //Expiration (open loop) period
            Serial.print("EXP PER: "); Serial.println(expirationPeriod);
            this -> inspirationClkCycles = 0; //Reset inspiration clock cycles counter
            this -> expirationClkCycles = 0; //Reset expiration clock cycles counter
            this->currentDirection = EXPI;
            homedMotors = 0; //Motors are not located in home position
            pp.setNewMaxOutput(MOTOR_MAX_OUT); //Reset max motor speed to default value 
            pp.resetIDvalues(); //Reset PID accumulated values

            maxExpirationCycles = (long)(expirationPeriod/(float)DT);

            //Serial.print("MXEXPCYC: "); Serial.println(maxExpirationCycles);

            
            newOutput = 0; //Momentaneusly pause motor to start direction reversion
        }

    }else if(this->currentDirection == EXPI){ //If current direction is expiration (pulling ambu out)

        //Serial.println("OUT ");

        newOutput = MOTOR_MIN_OUT;

        //Go to home until limit switches are activated (and keep counting elapsed time)
        //Wait until expiration time has been reached
        this -> expirationClkCycles += 1;

        #ifdef DEBUG_MODE
            Serial.print(" CLKEXP: "); Serial.println(this -> expirationClkCycles);
        #endif
        //Serial.print(" MAXXPRCY: "); Serial.println(maxExpirationCycles);

        if((this -> expirationClkCycles) < maxExpirationCycles){ //Has expiration time passed by?
            //If home hasn't been reached, keep moving motors to initial position
            if(homedMotors < TOTAL_MOTORS){
                for(i = 0; i < TOTAL_MOTORS; i++){
                    homedMotors += towardsHome(i); //Be sure each motor is moved towards home position
                    this -> setMotorSpeed(i, MOTOR_MIN_OUT);
                }
                //Serial.println("TWRDS");
            }else{ //Else, just wait until expiration time has been reached
                for(i = 0; i < TOTAL_MOTORS; i++){
                    this -> setMotorSpeed(i, 0);//Be sure motors are stopped at this point
                }
                //Serial.println("HOMED");
            }

        }else{ //If expiration cycle time has been reached, switch back to inspiration again

            Serial.println("HOMED EXP");

            //Compute inspiration expected cycles, in case pressure and flow stop working, due to a stuck motor at the end (STOP END Activated)
            maxInspirationCycles = (long)((this -> __computeIDuration(this->getSpRPM(), this->getSpIeRatio())/DT) * MAX_INSPIRATION_CYCLES_OVERLOAD_RATIO);

            #ifdef DEBUG_MODE
                Serial.print("MAX_INS_CYC: "); Serial.println(maxInspirationCycles);
            #endif 

            this -> inspirationClkCycles = 0;

            this->currentCycleSlope = this -> __computeISlope(this->getSpRPM(), this->getSpIeRatio(), this->getSpMinVol(), this->getSpMaxVol());
            this->setCurrentCycleVolume(0.0); //Now strat increasing volume again on next cycle
            accumulatedCycleVolume = 0;
            this->currentDirection = INSP;
            this -> updateSetPoint(this->currentCycleSlope);
            pp.resetIDvalues(); //Reset prior accumulated PID values
            newOutput = 0; //Momentaneusly pause motor to start direction reversion

            accumulatedOverPressureCycles = 0; 
        }     

        

    }else{ //No other states have been planned. If entering an invalid state, just shut motors off.
        pp.setNewMaxOutput(0);
        pp.setNewMinOutput(0);
        Serial.println("ERROR STATE");
        return 0; //Motors must be stopped
    } 

    return newOutput; //Return new motor speed value

    

}


//Left here for future implementations
// float arcontrol::controlFlow2(float currentFlow, float currentPressure){
//     float newOutput; //Current output
//     float accumulatedCycleVolume;
//     if(this->currentDirection == INSP){ //If pushing air into patient's lungs

//         if(currentPressure > this->getSpPressure()){ //If max. expected pressure is detected
//             this->__reduceMaxPIDOut(pp.getMaxOut()); //Gradually reduce motor output speed (inspiration only)
//         }

       
//         //Compute current cycle accumulated volume
//         accumulatedCycleVolume = this->computeCurrentCycleVolume(currentFlow);


//         //If maxvol hasn't been reached yet, keep pushing ambu
//         if(accumulatedCycleVolume < this->getSpMaxVol()){
            
//             newOutput = pp.pidUpdate(currentFlow);

//         }else{
//             //Otherwise, stop motor and change currentDirection to EXPIRATION
//             this->setCurrentCycleVolume(this->getSpMaxVol()); //Now start decreasing volume next clock cycle
//             this->currentDirection = EXPI;
//             pp.setNewMaxOutput(MOTOR_MAX_OUT); //Reset max motor speed to default value 
//             pp.resetIDvalues(); //Reset PID accumulated values

//             //Compute new negative PID slope for next respiration cycle (expiration)
//             this->currentCycleSlope = this -> __computeESlope(this->getSpRPM(), this->getSpIeRatio(), this->getSpMinVol(), this->getSpMaxVol());
//             newOutput = 0; //Momentaneusly pause motor to start direction reversion
//         }

//     }else if(this->currentDirection == EXPI){ //If current direction is expiration (pulling ambu out)
//         //Limit switches MUST be checked in Motor Control Module. Despite of the value sent from this module,
//         //Motor Control Module must check switches before acting.
//         accumulatedCycleVolume = this->computeCurrentCycleVolume((currentFlow)*(-1)); //Negative direction

//         //If minvol hasn't been reached yet, keep pulling ambu out
//         if(accumulatedCycleVolume > this->getSpMinVol()){            
//             newOutput = pp.pidUpdate(currentFlow);         
//         }else{
//             //Compute new set point (flow), according to volume, IE, RPM, parameters sent from GUI
//             //Compute new positive PID slope for next respiration cycle (inspiration)
//             this->currentCycleSlope = this -> __computeISlope(this->getSpRPM(), this->getSpIeRatio(), this->getSpMinVol(), this->getSpMaxVol());

//             this->setCurrentCycleVolume(this->getSpMinVol()); //Now strat increasing volume again on next cycle
//             this->currentDirection = INSP;
//             pp.resetIDvalues(); //Reset prior accumulated PID values
//             newOutput = 0; //Momentaneusly pause motor to start direction reversion
//         }



//     }else{ //No other states have been planned. If entering an invalid state, just shut motors off.
//         pp.setNewMaxOutput(0);
//         pp.setNewMinOutput(0);
//         return 0; //Motors must be stopped
//     } 


//     return newOutput; //Return new motor speed value

    

// }



// Compute total cycle volume, based on flow
float arcontrol::computeCurrentCycleVolume(float currentFlow){
    float lastVol = this->getCurrentCycleVolume();
    //Serial.print(" LstVol: "); Serial.println(lastVol);
    //Serial.println(currentFlow);
    return lastVol + (DT*currentFlow);
}

// Public setters and getters
float arcontrol::getCurrentSetPoint(){
    return pp.getSetPoint();
}


//Get current cycle volume
float arcontrol::getCurrentCycleVolume(){
    return this->currentCycleVolume;
}

//Set current cycle volume
float arcontrol::setCurrentCycleVolume(float newVolume){
    this->currentCycleVolume = newVolume;
    //Serial.println(newVolume); //IVAN  Debugging
}


//Set current motor speed for individual motor
void arcontrol::setMotorSpeed(int motorIndex, int value){
    this -> motorSpeed[motorIndex] = value;
}

int arcontrol::getMotorSpeed(int motorIndex){
    return (this -> motorSpeed[motorIndex]);
}


/*
===============
Private methods
===============
*/

float arcontrol::__computeRespirationPeriod(float rpm){
    return (60.0 / rpm); //60 seconds per minute
}


float arcontrol::__computeIDuration(float rpm, float ieRatio){
    float tResp = this -> __computeRespirationPeriod(rpm); //Compute respiration period in seconds
    float iDuration = tResp*ieRatio/(1 + ieRatio);  //Inspiration duration (in SECONDS)
    return iDuration;
}


float arcontrol::__computeEDuration(float rpm, float ieRatio){
    float tResp = this -> __computeRespirationPeriod(rpm); //Compute respiration period in seconds
    float eDuration = tResp/(1 + ieRatio);  //Expiration duration (in SECONDS)
    return eDuration;
}


//Compute Inspiration rate (slope). Dependent variable: Volume, Independent var: time (inspiration time) 
//This will help to set Motor Speed while pushing ambu. No further Calibration required
float arcontrol::__computeISlope(float rpm, float ieRatio, float minVol, float maxVol){
    float iDuration = this -> __computeIDuration(rpm, ieRatio);
    float deltaVol  = maxVol - minVol; //Inspiration volume delta (in cubic meters)
    return deltaVol/iDuration;
}


//Compute espiration rate (slope). Dependent variable: Volume, Independent var: time (expiration time) 
//This will help to set Motor Speed while "pulling out" ambu. No further Calibration required
//Negative output expected
float arcontrol::__computeESlope(float rpm, float ieRatio, float minVol, float maxVol){
    float eDuration = this -> __computeEDuration(rpm, ieRatio);
    float deltaVol  = minVol - maxVol; //Expiration volume delta (in cubic meters)
    return deltaVol/eDuration; 
}

//Reduce max output value if maximum pressure is exceeded
void arcontrol::__reduceMaxPIDOut(float currentMax){
    //OUTPUT_REDUCTION_FACTOR can be changed in "globals.h"

    //Min value untouched, as it's only used during expiration
    float newMax = (float) currentMax * OUTPUT_REDUCTION_FACTOR; 

    //Be sure to reach max volume while overpressure condition met
    newMax = newMax > MIN_MAX_OUTPUT ? newMax : MIN_MAX_OUTPUT;

    pp.setNewMaxOutput(newMax);

}



//Set max working pressure value, to protect patient's lungs
void arcontrol::__setSpPressure(float press){
    this -> spPressure = press;
}

//Set min opetariontal volume set-point, to avoid negative pressure
void arcontrol::__setSpMinVol(float minVol){
    this -> spVolMin = minVol;
}

//Set max opetariontal volume set-point, to protect patient's lungs
void arcontrol::__setSpMaxVol(float maxVol){
    this -> spVolMax = maxVol;
}

//Set respirations per minute set-point (respiration period)
void arcontrol::__setSpRPM(float rpm){
    this -> spRPM = rpm;
}

//Set Inspiration:Espiration ratio (respiration duty cycle)
void arcontrol::__setSpIeRatio(float ie){
    this -> spIEratio = ie;
}

//Set (1) Init Parameters Flag
void arcontrol::__setInitParametersFlag(){
    this -> initParametersReceived = 1;
}

//Reset (0) Init Parameters Flag
void arcontrol::__resetInitParametersFlag(){
    this -> initParametersReceived = 0;
}


//Getters and setters

//Get Init parameters flag
int arcontrol::__getInitParametersFlag(){
    return this -> initParametersReceived;
}

//Get max working pressure value, to protect patient's lungs
float arcontrol::getSpPressure(){
    return this -> spPressure;
}

//Get min opetariontal volume set-point, to avoid negative pressure
float arcontrol::getSpMinVol(){
    return this -> spVolMin;
}

//Get max opetariontal volume set-point, to protect patient's lungs
float arcontrol::getSpMaxVol(){
    return this -> spVolMax;
}

//Get respirations per minute set-point (respiration period)
float arcontrol::getSpRPM(){
    return this -> spRPM;
}

//Get Inspiration:Espiration ratio (respiration duty cycle)
float arcontrol::getSpIeRatio(){
    return this -> spIEratio;
}
