imoralesgt/AR_CODEX/Control/arcontrol.h

//#include "globals.h"
#include "pinout.h"

#ifndef ARCONTROL_H
#define ARCONTROL_H

//ENUMERATE STATUS INSPIRATION EXPIRATION

class arcontrol{

    public:

        /*
        ======================
        Global class variables
        ======================
        */

       /*
        Sensor and set-point values must be given
        in base SI units. e.g. [Volume] = m³,
        [Pressure] = Pa, [Air Flow] = m³/s.

        Special variables must be strictly commented,
        such as [Respirations per minutes] = 1/(minutes)
       */

        enum Direction {INSP, EXPI};

        //IRM Sensor-related variables
        float pressure = 0.0;
        float airFlow  = 0.0;
        float volume   = 0.0;

        //IRM GUI-related input set-point variables
        float spPressure = 0.0; //Pressure set-point
        float spVolMin   = 0.0; //Minimum volume set-point
        float spVolMax   = 0.0; //Maximum volume set-point
        float spRPM      = 0.0; //Respirations-per-minute set-point
        float spIEratio  = 0.0; //I:E ratio set-point


        //IRM Motor-related variables
        int motorSpeed[TOTAL_MOTORS];

        //IRM Motors have been homed?
        volatile int motorsHomed = 0;

        //IRM Motors currently homing
        int motorsHoming;

        //IRM Control-related variables
        float controlSetPoint = 0.0;

        //IRM initialization (set-point) parameters received from GUI FLAG
        unsigned int initParametersReceived;

        //IRM current cycle (INSP/EXP) volume, computed based on flow
        float currentCycleVolume = 0.0;

        //IRM Current flow (volume slope) set point
        float currentCycleSlope = 0.0;

        //IRM Flow Direction
        Direction currentDirection = INSP;

        //IRM Expiration Clk Cycles
        long expirationClkCycles;


        //IRM Inspiration Clk Cycles
        long inspirationClkCycles;

        /*
        ====================
        Global class methods
        ====================
        */

        //AR_CODEX Main control class module
        arcontrol();
        
        ~arcontrol();


        //IRM Public methods

        //IRM Gets init parameters from GUI I2C Controller, which are set as working set-points. Returns 0 if everything ok
        int setInitParameters(float pressure, float minVol, float maxVol, float rpm, float ieRatio);

        //IRM Update control parameters on-the-fly
        void updateControlParameters(float pressure, float minVol, float maxVol, float rpm, float ieRatio);

        //IRM Updates current set-point value in PID controller
        void updateSetPoint(float sp);

        //Check initial positions for individual motors and move once
        int towardsHome(int motorIndex);

        //Do full homing process
        void goHome(void);

        //Override default MAX value if max pressure is reached
        void __reduceMaxPIDOut(float max);

        //Main control system method, should be called periodically
        float controlFlow(float currentFlow, float currentPressure);

        //Main control system method, should be called periodically. Left for future implementations
        float controlFlow2(float currentFlow, float currentPressure);

        //Compute current cycle volume
        float computeCurrentCycleVolume(float newDeltaVolume);


        // Public setters & getters

        //IRM return current set point from PID controller
        float getCurrentSetPoint();
        
        //Get max working pressure value, to protect patient's lungs
        float getSpPressure();

        //Get min opetariontal volume set-point, to avoid negative pressure
        float getSpMinVol();

        //Get max opetariontal volume set-point, to protect patient's lungs
        float getSpMaxVol();

        //Get respirations per minute set-point (respiration period)
        float getSpRPM();

        //Get Inspiration:Espiration ratio (respiration duty cycle)
        float getSpIeRatio();


        //Get current cycle volume
        float getCurrentCycleVolume();

        //Set current cycle volume
        float setCurrentCycleVolume(float newVolume);

        //Set independent motor speed
        void setMotorSpeed(int motorIndex, int value);

        //Get independent motor speed
        int getMotorSpeed(int motorIndex);



    private:


        /*
        ====================
        Encapsulated methods
        ====================
        */

        //Compute respiratory period (in seconds) form respiratory rate (in minutes)
        float __computeRespirationPeriod(float rpm);

        //Compute inspiration duration (in seconds), based on RPM and I:E Ratio 
        float __computeIDuration(float rpm, float ieRatio);

        //Compute expiration duration (in seconds), based on RPM and I:E Ratio 
        float __computeEDuration(float rpm, float ieRatio);

        //Compute Inspiration rate (slope). Dependent variable: Volume, Independent var: time (inspiration time) 
        //A positive value is expected
        float __computeISlope(float rpm, float ieRatio, float minVol, float maxVol);
        
        //Compute Expiration rate (slope). Dependent variable: Volume, Independent var: time (expiration time) 
        //Expected negative slope
        float __computeESlope(float rpm, float ieRatio, float minVol, float maxVol);


        /*
        ================================
        Encapsulated Setters and getters
        ================================
        */

        //Set max working pressure value, to protect patient's lungs
        void __setSpPressure(float press);

        //Set min opetariontal volume set-point, to avoid negative pressure
        void __setSpMinVol(float minVol);

        //Set max opetariontal volume set-point, to protect patient's lungs
        void __setSpMaxVol(float maxVol);

        //Set respirations per minute set-point (respiration period)
        void __setSpRPM(float rpm);

        //Set Inspiration:Espiration ratio (respiration duty cycle)
        void __setSpIeRatio(float ie);

        //Set or reset Init Parameters Already Received Flag
        void __setInitParametersFlag();
        void __resetInitParametersFlag();



        //Get Init parameters flag
        int __getInitParametersFlag();


};


#endif
