imoralesgt/AR_CODEX/Control/argpio.cpp

#include "argpio.h"
#include "pinout.h"
#include "Arduino.h"

argpio::argpio(){
    ;
}

argpio::~argpio(){
    ;
}

void argpio::initIOs(void){
    int i;

    //Initialize motors and motor-related end/start stop switches
    for(i = 0; i < TOTAL_MOTORS; i++){
        this -> pSetup(MOTOR[i], OUTPUT); //Outputs
        this -> dWrite(MOTOR[i], 0); //Clear outputs
        this -> pSetup(START_ENDSTOP[i], INPUT_PULLUP); //Inputs
        this -> pSetup(END_ENDSTOP[i], INPUT_PULLUP); //Inputs
    }

    this -> pSetup(DEBUG_AMBU_DIRECTION, OUTPUT);
    this -> dWrite(DEBUG_AMBU_DIRECTION, 0);

    this -> pSetup(VALVE0_OUTPUT, OUTPUT);
    this -> dWrite(VALVE0_OUTPUT, 0);

    this -> pSetup(VALVE1_OUTPUT, OUTPUT);
    this -> dWrite(VALVE1_OUTPUT, 0);

    this -> pSetup(VALVE2_OUTPUT, OUTPUT);
    this -> dWrite(VALVE2_OUTPUT, 0);

    this -> pSetup(BUZZER_OUT, OUTPUT);
    this -> dWrite(BUZZER_OUT, 0);

}

void argpio::pSetup(uint8_t pin, uint8_t mode){
    pinMode(pin, mode);
}

void argpio::dWrite(uint8_t pin, int value){
    digitalWrite(pin, value);
}


int argpio::dRead(uint8_t pin){
    return digitalRead(pin);
}
