imoralesgt/AR_CODEX/Sensors/Firmware/Testing/msp430_code/analog_read.c/pinout.h

//Analog inputs 
int sensorP = A0; 
int sensorV = A4;
int sensorF = A5;

//calibration mode pin, INPUT_PULLUP if is push button, else pinMode set to PULLUP
int calbit = PUSH2; 
