imoralesgt/AR_CODEX/Control/motorControlTest.cpp

#include "motorControlTest.h"
#include "pinout.h"
#include "globals.h"
#include "Arduino.h"


volatile int motorCurrentDir;
volatile int intToggle2 = 0;

volatile int steppingEnabled;

void motorSetDirection(int direction){
	//digitalWrite(PIN_DIRECTION, direction); //REMOVE this instruction, as has been set inside the timer interrupt
	motorCurrentDir = direction;
}

void motorSetSpeed(int speed){
	
	if (speed < (int)(0 - SPEED_HYSTERESIS)){
		motorSetDirection(1);
		motorEnableSteppers();
		OCR1A = motorComputeTimerFromSpeed(speed);
		//Serial.println("BKWRDS");
	}else if(speed > SPEED_HYSTERESIS){
		motorSetDirection(0);
		motorEnableSteppers();
		OCR1A = motorComputeTimerFromSpeed(speed);
		//Serial.println("FRWRD");
	}else{
		//motorSetDirection(0);
		motorDisableSteppers();
		//Serial.println("STOP");
	}
	
}

// void motorSetSpeed2(int index, int speed){
// 	motorEnableSteppers();
// 	if (speed < (-1)*(SPEED_HYSTERESIS)){
// 		motorSetDirection(1);
// 	}else if(speed > SPEED_HYSTERESIS){
// 		motorSetDirection(0);
// 	}else{
// 		motorDisableSteppers();
// 	}
// 	OCR1A = motorComputeTimerFromSpeed(speed);
// }


void motorEnableSteppers(void){
	steppingEnabled = 1;
}

void motorDisableSteppers(void){
	steppingEnabled = 0;
}


int motorComputeTimerFromSpeed(int speed){
	const int MIN_TIMER = MIN_MOTOR_TIMER;
	const int MAX_TIMER = MAX_MOTOR_TIMER;
	int computedSpeed;

	//Serial.println(speed);

	//Serial.print("SPD: "); Serial.println(speed);

	if(speed < 0){
		speed = (speed)*(-1);
		computedSpeed =  (int)map(speed, 0, (-1)*(MOTOR_MIN_OUT), MAX_TIMER, MIN_TIMER);
	}else if(speed > 0){
		computedSpeed = (int)map(speed, 0, MOTOR_MAX_OUT, MAX_TIMER, MIN_TIMER);
	}else{
		return 0;
	}

	
	//Serial.print("MSPD: "); Serial.println(computedSpeed);

	return computedSpeed;
}


ISR(TIMER1_COMPA_vect){
	int i, startSwitchEnabled;

	intToggle2 ^= 1;
	
	//digitalWrite(PIN_MOTOR2, (intToggle2&steppingEnabled)); //Individual motor test


	digitalWrite(PIN_DIRECTION, motorCurrentDir);

	for(i = 0; i < TOTAL_MOTORS; i++){
		startSwitchEnabled = digitalRead(START_ENDSTOP[i]);

		//motorCurrentDir means motors are pulling out (retracting)
		//startSwitchEnabled indicates that an individual start switch has been activated
		//If both conditions are met, stop each motor individually, otherwise, send a step 

		if(!(motorCurrentDir&startSwitchEnabled)){
			digitalWrite(MOTOR[i], (intToggle2&steppingEnabled));
		}

	}

	
}
