imoralesgt/AR_CODEX/(commit log)

2020-04-08 Added windup prevention. Improved requested parameters format to be more user-friendly.
    [Pid.cpp, Pid.h]
2020-04-10 Arduino example added.
2020-04-10 Arduino Library file added in zip format
2020-04-10 Fixed Arduino Library bug
    [globals.h]
2020-04-11 Updated Arduino Library file system
    Removed x86 example
2020-04-17 Added firmware modular design
    Includes tentative required hardware resources form ESP32
2020-04-17 Arduino (ESP32) setup for VSCode
2020-04-17 Started developing respirator-related custom algorithms to feed PID control system
2020-04-22 Fixed file system structure.
    [Control.ino, Pid.cpp, Pid.h, arcontrol.cpp, arcontrol.h, globals.h, pinout.h]
2020-04-22 Control system implemented. Flow control done during ins and exp cycles.
2020-04-25 ATmega328P Initial Timer Test
    As expected, computational stress test was successfull, achieveng almost 3000 PID computations per second: this performance exceeds by 10 times the minimum requirements. Further test should be done; however, ATmega328p seems to have enought computational power to accomplish our tasks.
2020-04-25 ATmega328p performance test with AR_CODEX library
    Achieved up to 2.1k respirator computations per second. Timer 2 as default sampling trigger.
    Timer 1 suggested as motor driver time base.
2020-04-25 1 KHz interrupt rate tested. 600 ms interval allows up to 1100 computations to be done
2020-04-27 Interrupt rate 1 kHz
2020-04-27 Timer setup template added
2020-04-27 Power-saving mode disabled
2020-04-27 Power-saving disabled, timers enabled
2020-04-27 Timer synchronization implemented
2020-04-27 Added Timer1 initial setup
2020-04-27 Added timer sync to main loop
2020-04-30 Hardware abstraction layer for basic IO operations
    So main algorithm will call high-level IO operations corresponding to board-specific instructions through a common instruction (abstracion layer).
2020-04-30 Added motors and endstop switches definitions for loop access control
2020-04-30 Added homing and updated expiration algorithm
2020-04-30 Added homing instruction at the begining
2020-05-05 Added motor control test code
    Working on Timer 1 interrupts
2020-05-05 Fixed motor timer computation typo
    [motorControlTest.cpp]
2020-05-05 Fixed PID implementation bug
    [Pid.cpp]
2020-05-05 Added motor direction pin and ambu debug pin
2020-05-05 Added motor speed hysteresis value
2020-05-05 Implemented motor speed control, based on input sensor value, commanded by PID controller
2020-05-08 Fixed direction pin bug. Using temporary output debug pin
    [Control.ino, arcontrol.cpp, motorControlTest.cpp, motorControlTest.h]
2020-05-08 First PID calibration tests
2020-05-13 Temporary start endswitch support 3D design
    [EndSwitch.0001.ipt, EndSwitch.ipt, StartAssembly.0001.iam, StartAssembly.iam, StartSupport.0007.ipt, StartSupport.ipt]
2020-05-13 Fixed temporary support dimensions for ease of 3D printing
    [StartAssembly.0001.iam, StartAssembly.0002.iam, StartAssembly.iam, StartSupport.0007.ipt, StartSupport.0009.ipt, StartSupport.ipt]
2020-05-13 Added I2C Interfaces and data buffer code. NOT TESTED YET
2020-05-14 Added I2C basic tests to main loop
2020-05-14 Changed some basic operations to fix bug of pulsating motorDirection pin
    [motorControlTest.cpp]
2020-05-14 Removed unnecesary I2C original file
2020-05-14 Configured I2CComms to be integrated into the project, according to source-code files system
2020-05-20 Included I2C variables to interact with main Control System
    - Received GUI parameters
    - Real-time sensor values
2020-05-23 Fixed pin definitions for PCB
    [i2cComms.cpp, i2cComms.h, pinout.h]
2020-05-23 Added logic code to avoid motor stepping while endstop switch is enabled.
    Multiple motors supported.
    [motorControlTest.cpp, motorControlTest.h]
2020-05-24 Added missing IOs to initialization method
    [argpio.cpp, globals.h]
2020-05-24 Now supports 3 motors by default: only set corresponding GPIOs in pinout.h
2020-05-24 Fixed GPIOs rols, not used for deubugging any more
    [Control.ino, arcontrol.cpp, motorControlTest.cpp]
2020-05-24 Added I2C emulators for sensors and GUI testing beds
2020-06-12 Applied conversion factors for set points and sensor data
2020-06-14 Fixed I2C Address and SoftI2C working parameters
    [i2cComms.h]
2020-06-14 Optimized external I2C emulators
2020-06-14 Updated PID parameters
2020-06-14 Optimized motor controller timer overflow value
2020-06-14 Fixed sensors' I2C Address
2020-06-14 Added Sensors (GitLab pull) Design
    [3296W-1-250--3DModel-STEP-56544.STEP, Codo_boquilla.stl, MPX10DP--3DModel-STEP-56544.STEP, RedPVC_Manguera.stl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]
2020-06-14 Added Control PCB design
    [PCB-fuente.kicad_pcb, PCB-fuente.sch, imrpimir.kicad_pcb]
2020-09-03 Wrapping everything up. Sensors now work fine. Preliminary PID tunning.
    [Conector.0004.iam, Conector.iam, Conector.stl, PCB_SMF3300.0005.ipt, PCB_SMF3300.ipt, SMF3300_CONECTOR.0009.ipt, SMF3300_CONECTOR.ipt, SMF3300_CONECTOR.stl]
2020-09-04 Tuned PID to improve responsiveness
2020-09-09 Tried to improve over-pressure condition detection and fix
    [Control.ino, arcontrol.cpp, globals.h]
2020-09-09 Fixed overpressure condition response action
    [Control.ino, arcontrol.cpp]
2020-09-11 Reduced min motor speed
2020-09-11 Now each motor returns towards home independently, while exhalation occurs
2020-09-14 Reduced inspiration glitch significantly
    [Control.ino, Firmware.ino, arcontrol.cpp, arcontrol.h, globals.h, i2cComms.cpp, i2cComms.h, motorControlTest.cpp]
2020-09-14 Added inspiration limit control. Now, it goes backwards after detecting no flow during inspiration any more.
